revk/OpenMic/PCB/README.md

## Trademark

This is an open source project, but bear in mind you cannot sell boards bearing the Andrews & Arnold Ltd name, the A&A logo, the registered trademark AJK logo, or the GS1 allocated EANs assigned to Andrews & Arnold Ltd.

# PCBs

Audio Recorder

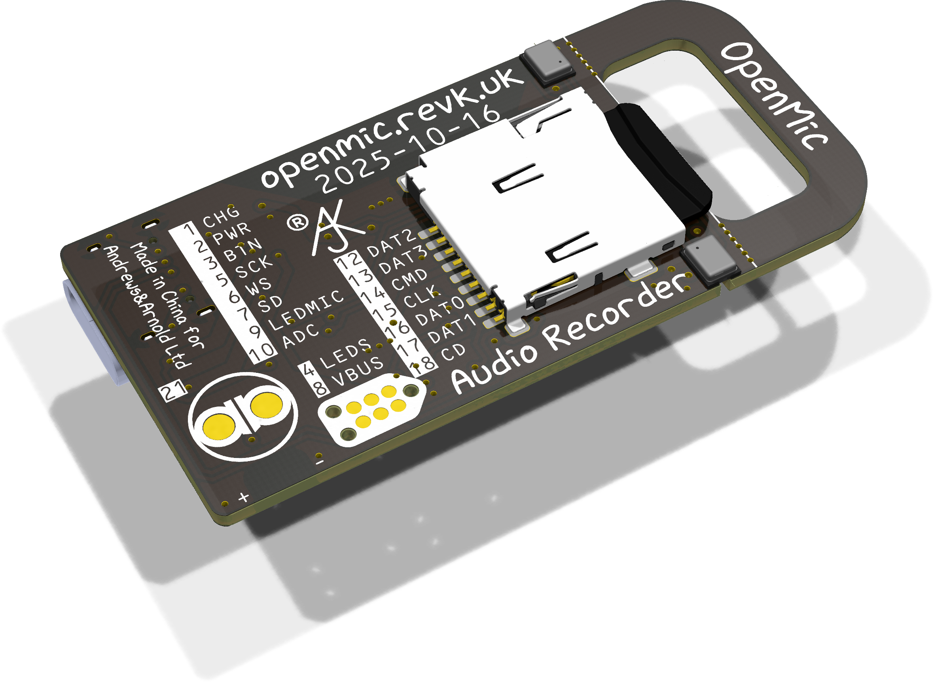
[picture p2: PCB/Recorder/Recorder-bottom.png]


Comm Badge roundel

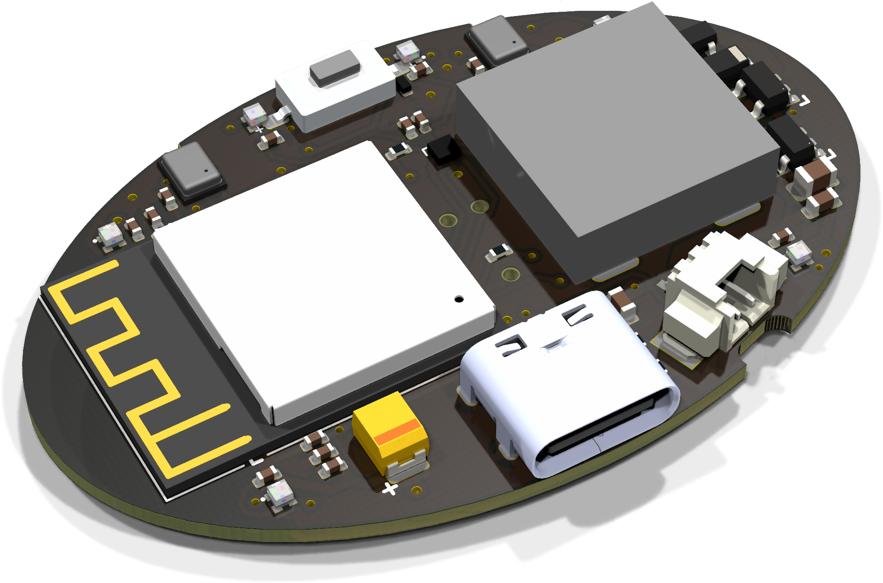
[picture p3: PCB/CommBadge/CommBadge.png]
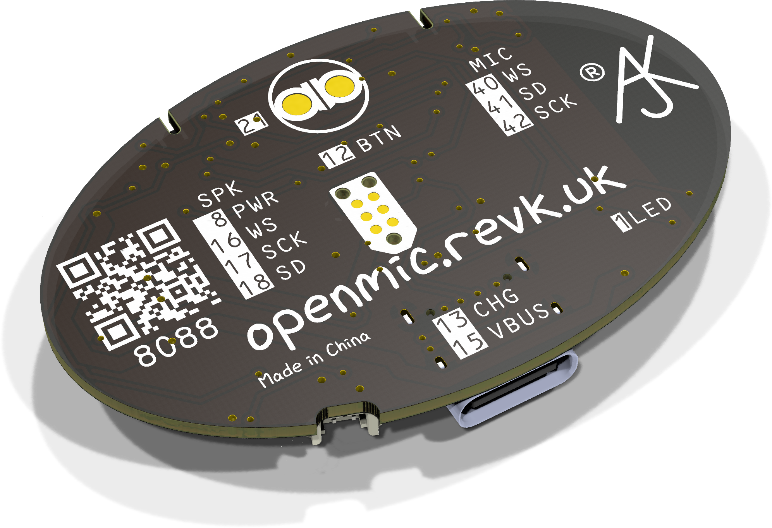
[picture p4: PCB/CommBadge/CommBadge-bottom.png]
