revk/OpenMic/PCB/Intercom/README.md

# Intercom

These files are for use in [KiCad](https://www.kicad.org).

## Trademark

This is an open source project, but bear in mind you cannot sell boards bearing the Andrews & Arnold Ltd name, the A&A logo, the registered trademark AJK logo, or the GS1 allocated EANs assigned to Andrews & Arnold Ltd.

## Images

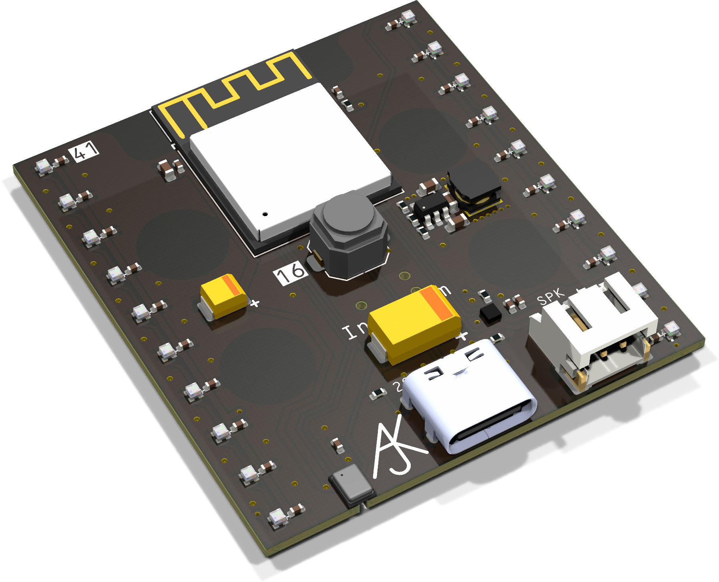
[picture p5: PCB/Intercom/Intercom.png]
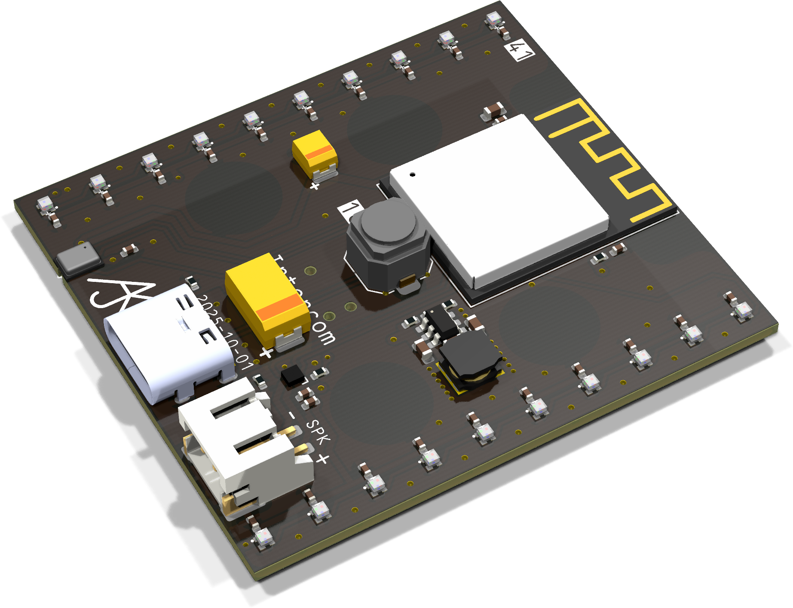
[picture p6: PCB/Intercom/Intercom-90.png]
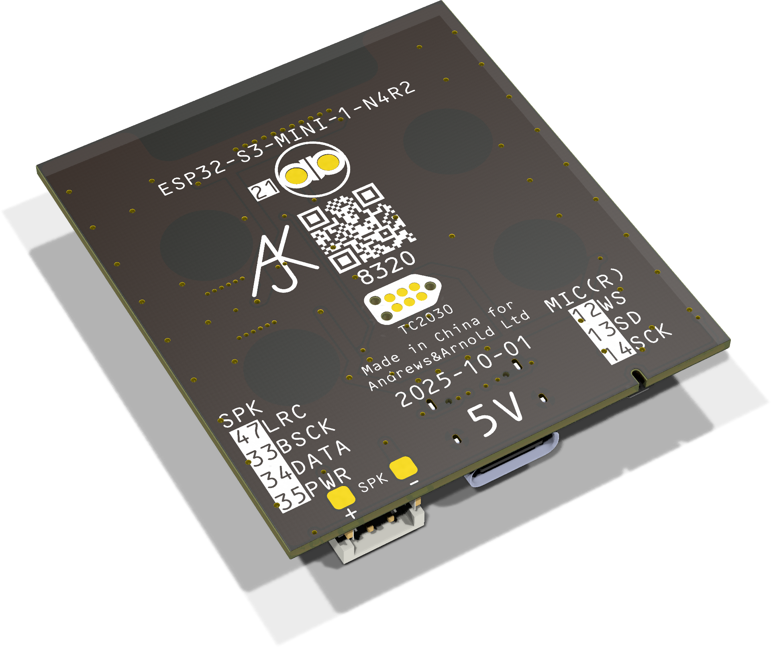
[picture p7: PCB/Intercom/Intercom-bottom.png]

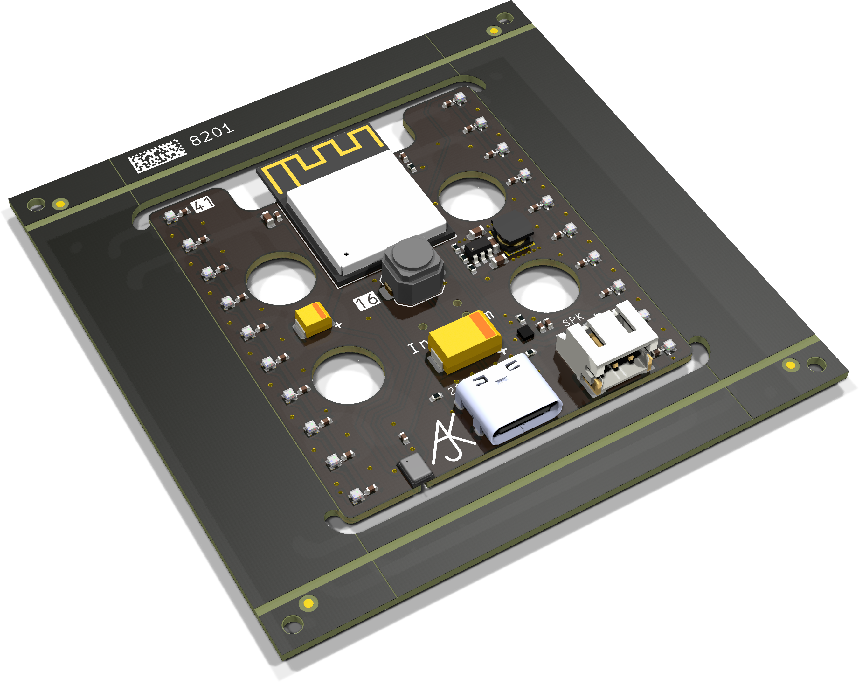
[picture p8: PCB/Intercom/Intercom-panel.png]
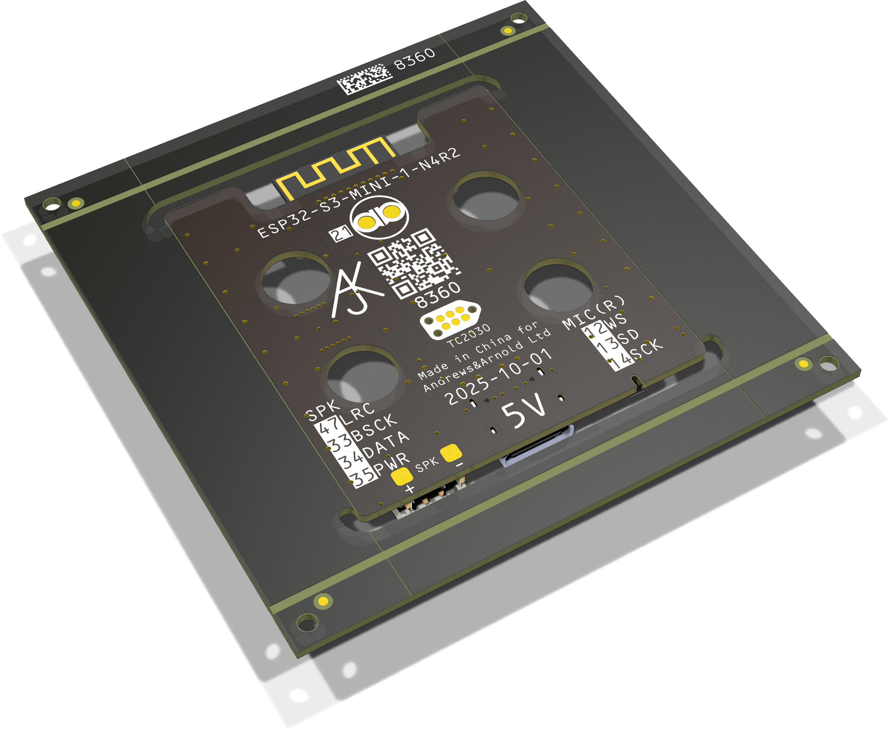
[picture p9: PCB/Intercom/Intercom-panel-bottom.png]


*Auto generated 2025-08-10T15:43:51*
