revk/OpenMic/PCB/Recorder/README.md

# Recorder

These files are for use in [KiCad](https://www.kicad.org).

## Trademark

This is an open source project, but bear in mind you cannot sell boards bearing the Andrews & Arnold Ltd name, the A&A logo, the registered trademark AJK logo, or the GS1 allocated EANs assigned to Andrews & Arnold Ltd.

## Images

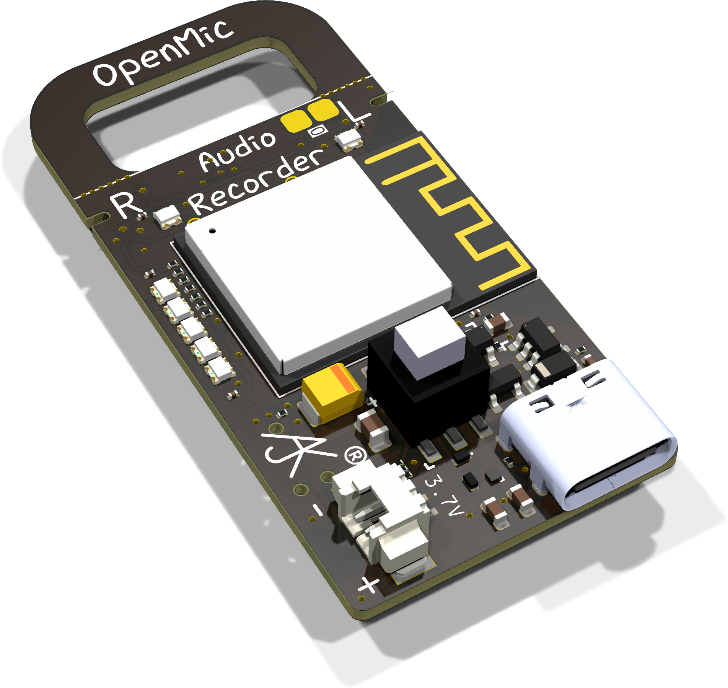
[picture p10: PCB/Recorder/Recorder-90.png]

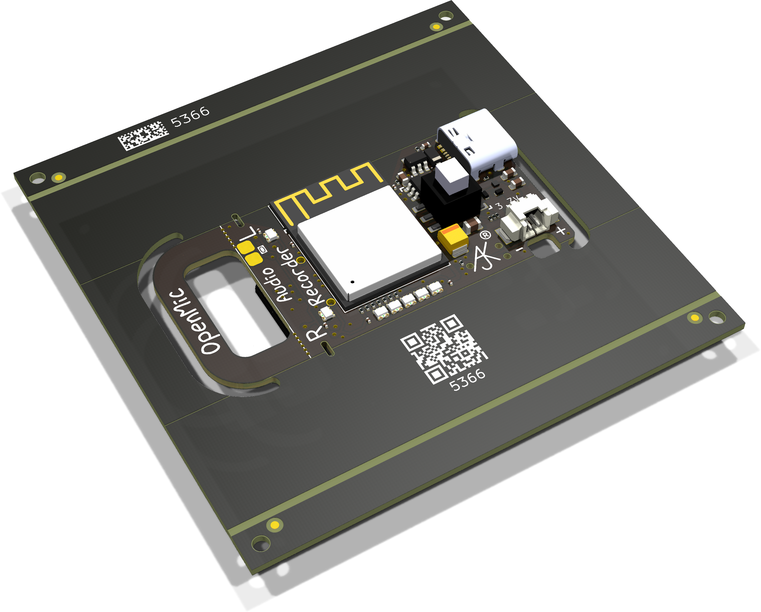
[picture p11: PCB/Recorder/Recorder-panel.png]
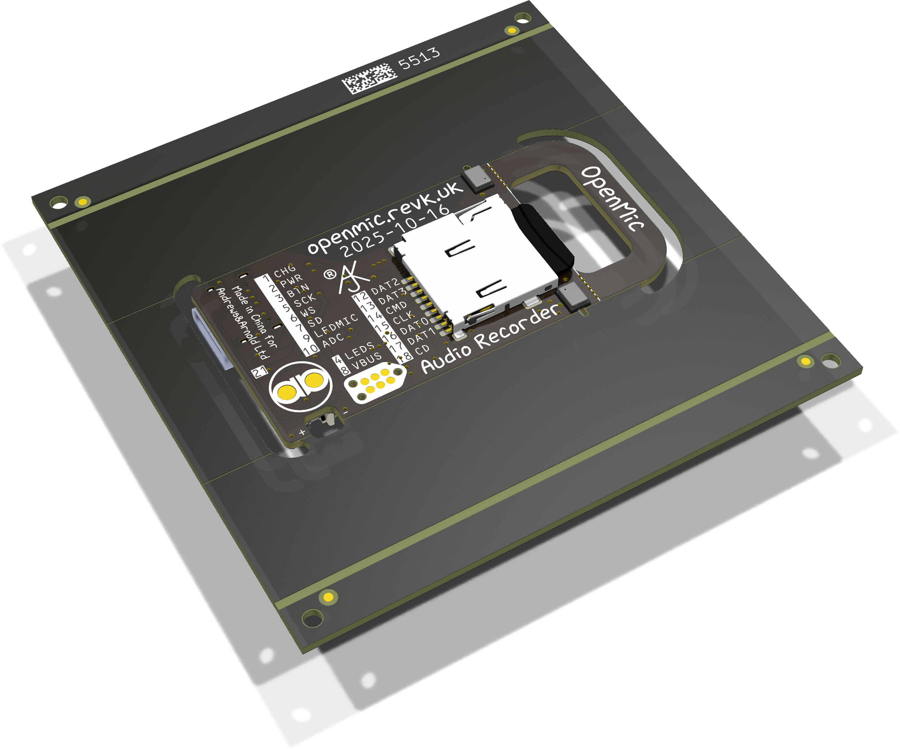
[picture p12: PCB/Recorder/Recorder-panel-bottom.png]


*Auto generated 2025-08-10T16:03:46*
