revk/OpenMic/PCB/CommBadge/README.md

# CommBadge

Top
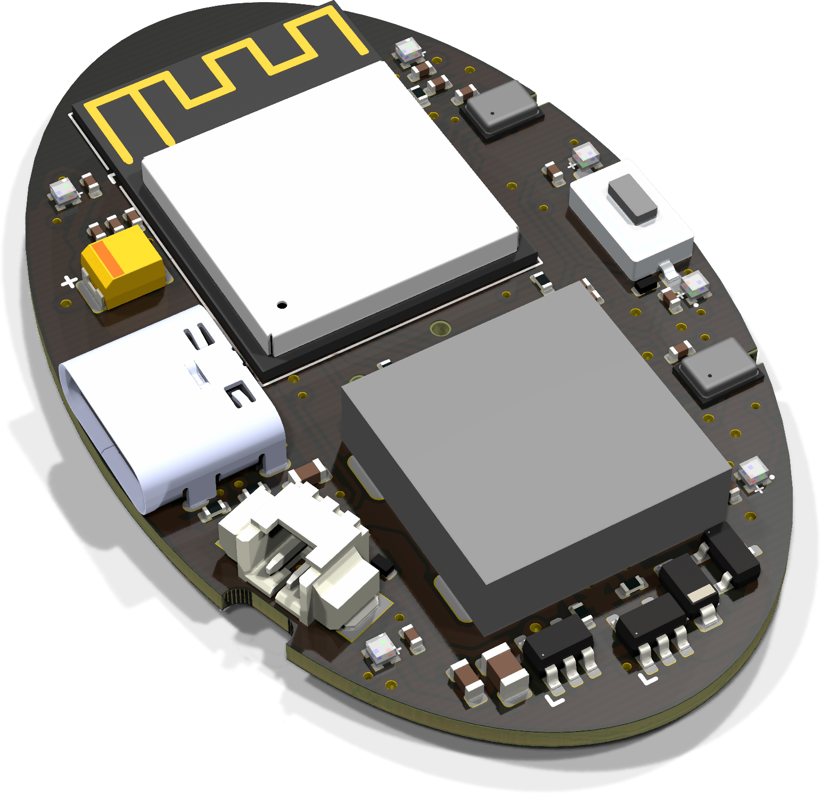
[picture p13: PCB/CommBadge/CommBadge-90.png]
Top rotated

Bottom
