revk/OpenMic/PCB/Recorder-2025-07-07-NoTag.stl

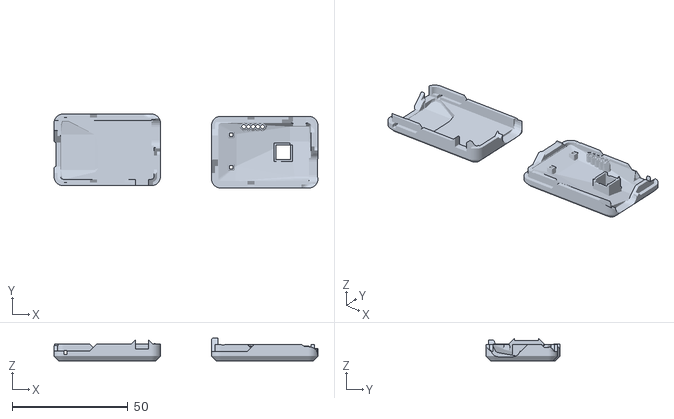
[picture p14: CAD file, 2025-08-11]
PCB/Recorder-2025-07-07-NoTag.stl
114.0 x 32.0 x 9.78
