revk/OpenMic/PCB/Recorder/RecorderB.stl

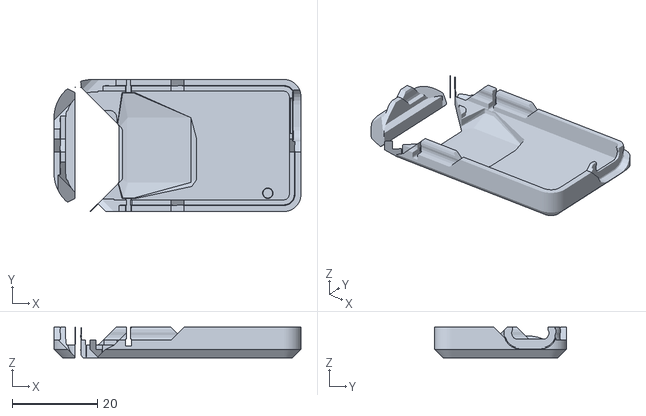
[picture p15: CAD file, 2025-10-16]
PCB/Recorder/RecorderB.stl
58.0 x 31.0 x 7.20
