revk/OpenMic/PCB/Recorder-2025-07-07.stl

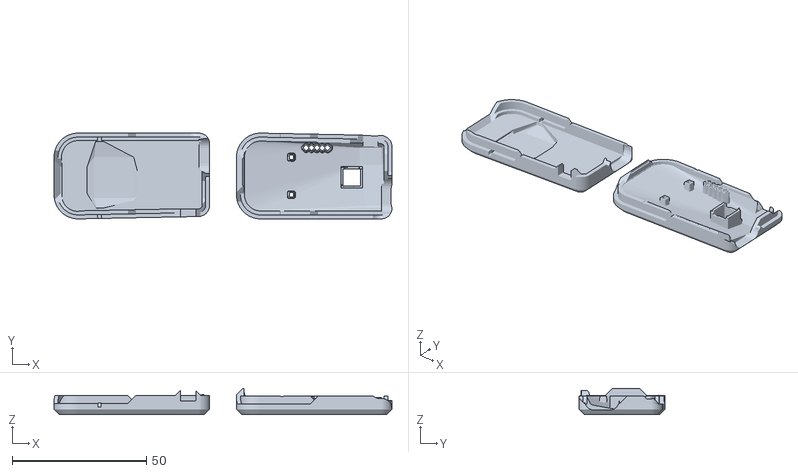
[picture p16: CAD file, 2025-08-11]
PCB/Recorder-2025-07-07.stl
126.0 x 32.0 x 9.81
