revk/OpenMic/PCB/Recorder/RecorderBatNoTagT.stl

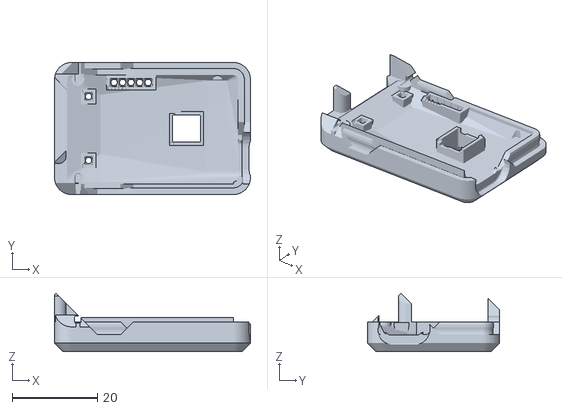
[picture p17: CAD file, 2025-10-16]
PCB/Recorder/RecorderBatNoTagT.stl
46.0 x 31.0 x 13.7
