revk/OpenMic/PCB/Recorder/RecorderT.stl

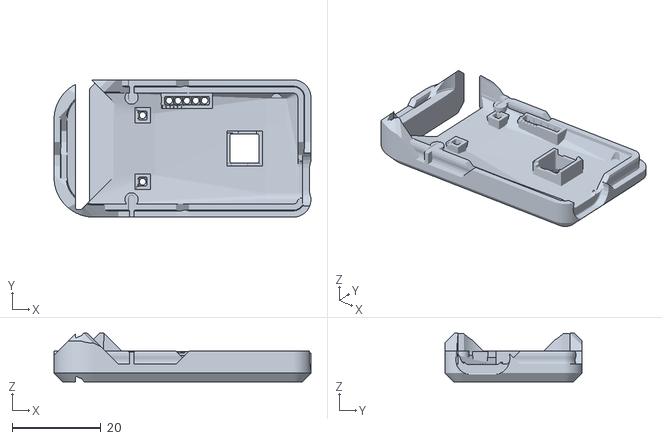
[picture p18: CAD file, 2025-10-16]
PCB/Recorder/RecorderT.stl
58.0 x 31.0 x 11.0
