revk/OpenMic/PCB/Recorder/RecorderNoTagB.stl

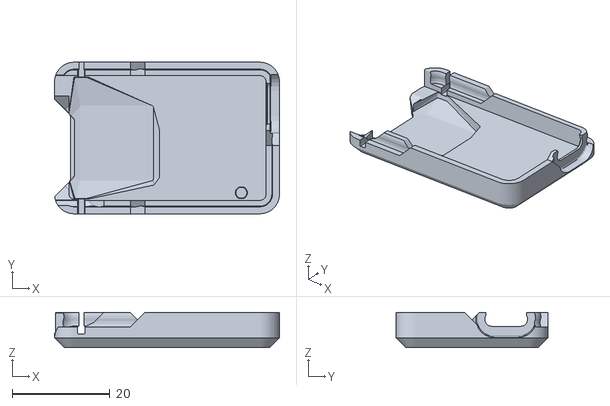
[picture p19: CAD file, 2025-10-16]
PCB/Recorder/RecorderNoTagB.stl
46.0 x 31.0 x 7.20
