revk/OpenMic/PCB/Recorder/RecorderBatB.stl

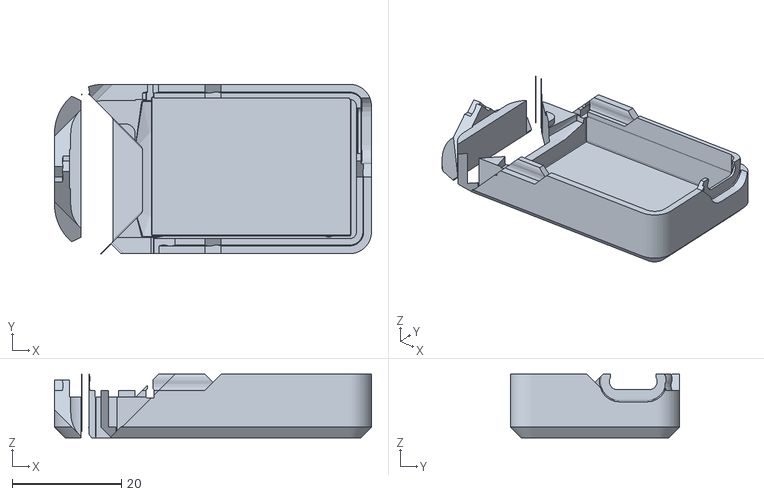
[picture p20: CAD file, 2025-10-16]
PCB/Recorder/RecorderBatB.stl
58.0 x 31.0 x 11.7
