revk/OpenMic/PCB/Recorder/RecorderBatNoTagB.stl

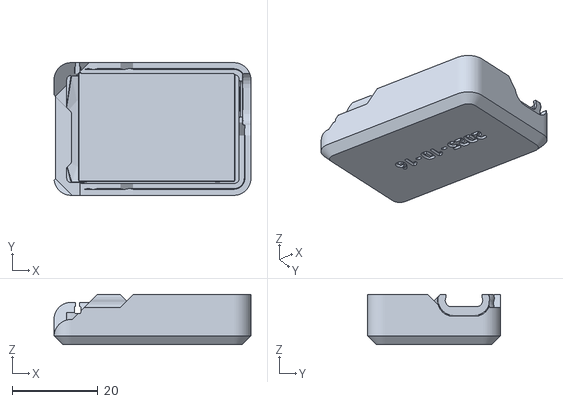
[picture p21: CAD file, 2025-10-16]
PCB/Recorder/RecorderBatNoTagB.stl
46.0 x 31.0 x 11.7
