revk/OpenMic/PCB/Recorder/RecorderBatT.stl

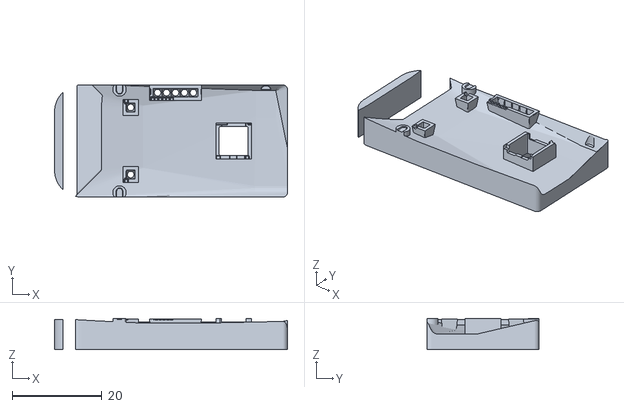
[picture p22: CAD file, 2025-10-16]
PCB/Recorder/RecorderBatT.stl
52.1 x 25.1 x 7.00
