revk/OpenMic/PCB/Recorder/RecorderNoTagT.stl

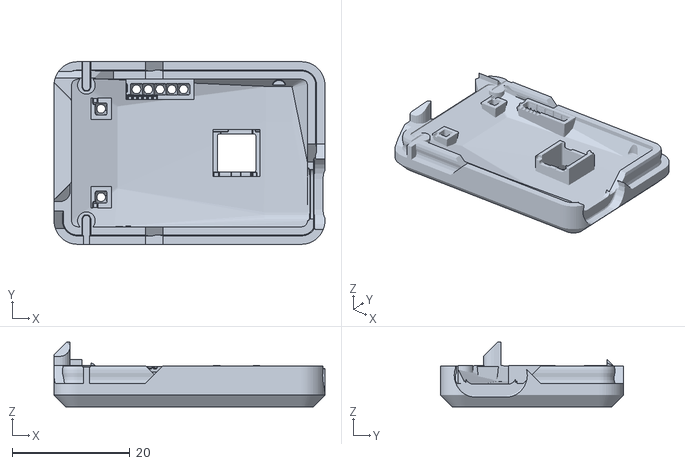
[picture p23: CAD file, 2025-10-16]
PCB/Recorder/RecorderNoTagT.stl
46.0 x 31.0 x 11.0
