revk/OpenMic/(list of files, cad)

Other CAD files:
PCB/Recorder/RecorderB.scad
PCB/Recorder/RecorderBat.scad
PCB/Recorder/RecorderBatB.scad
PCB/Recorder/RecorderBatNoTagB.scad
PCB/Recorder/RecorderBatNoTagT.scad
PCB/Recorder/RecorderBatNotTagB.scad
PCB/Recorder/RecorderBatNotTagT.scad
PCB/Recorder/RecorderBatT.scad
PCB/Recorder/RecorderNoTag.scad
PCB/Recorder/RecorderNoTagB.scad
PCB/Recorder/RecorderNoTagT.scad
PCB/Recorder/RecorderT.scad
