revk/OpenMic/(threads)

Thread 2 (2025-02-13):

Button always seems to goto sleep

sammachin, 2025-02-13:
Have got the SIP stuff mostly working on the commbadge,
The only issue I am having is the button seems to put the badge into deep sleep even with a short press, so I can't get it to answer or make a SIP call.

When I just tap the button I get the following on the serial console
E (37529) LWMQTT: Closed cleanly
E (37640) wifi_init: Wi-Fi not stop
E (37671) OpenMic: Deep sleep on button 12 high
[Disconnected]
The the device immediatly starts up again.
I'm running on USB power and have autousb set to on

revk, 2025-02-14:
What GPIO have you set.

The button is active low so needs a minus in front of the GPIO.

sammachin, 2025-02-14:
ah ok, yes that works better now, thanks.

Closed 2025-02-14.

Thread 4 (2025-07-05):

general developer docs

nickfreemandesign, 2025-07-05:
Hey there. Such a cool project and I've learned a ton from playing around with this. I picked up your recorder from your store and was able to get up and running quickly with recording to local storage. My goal has been to set up bluetooth advertising so I can connect to my phone and pass these recordings down based on particular logic (such as when mobile application requests it). Note I'm a software engineer but I've no experience in C, nor hardware including ESP32

A few things I stumbled across trying to run my own build then flash it on the device, wondering if you can guide me a bit:

- `popt` seems to be a requirement to build when running `make all`, I guess its used for your extended system config settings. I don't fully get how system pathing works to get dependencies but I have it installed using homebrew through macOS. The error is that it cant find `popt` when building
- When running `idf.py build` however I did get a build. Flashing this build however broke the device (no blinking lights and monitor seemed to indicate a loop the boot sequence was in) I assume is because that command doesnt build the submodules
- I flashed the release folder onto the device and got blinky lights again, but nothing records and the button doesnt appear responsive. Monitoring the device to figure out whats different, I don't see any meaningful logs

```
# how i flashed the release folder
esptool.py --chip esp32s3 --port /dev/cu.usbmodem101 --baud 460800 write_flash \
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
```

```
# monitor command
E (257) OpenMic: Started
E (384) RevK: Connect IoT
E (389) OpenMic: Spk init BCLK 35 DAT 36 LR 34
E (389) OpenMic: Mic mode 1
E (392) OpenMic: Spk started mode 2, 160*1*16 bits at 8000Hz
E (396) wifi_init: Wi-Fi not stop
E (398) OpenMic: Mic init CLK 44 DAT 43 WS 42
E (404) OpenMic: Mic started mode 1, 4410*1*32 bits at 44100Hz - mapped to 1*16 bits
E (514) RevK: Connect MQTT0 mqtt.iot as OpenMic:48CA43591F20
E (515) OpenMic: Mic stopped
E (2254) RevK: Connect IoT
E (5254) RevK: Connect IoT
E (8254) RevK: Connect IoT
E (11254) RevK: Connect IoT
E (12255) RevK: APSTA config mode start OpenMic-48CA43591F20
E (12266) httpd: httpd_server_init: error in listen (112)
E (14431) OpenMic: Spk stopped
E (20254) RevK: Connect IoT
E (30254) RevK: Connect IoT
E (40254) RevK: Connect IoT
E (50254) RevK: Connect IoT
```

My expectation is `bt` from the esp-idf components should be imported somewhere to confirm that bluetooth capabilities can be accessed, but also just a guess

If you don't mind giving me a nudge in the right direction, my questions are:
- What is the best way to build the source code (such that I can reproduce whats in the `release` folder) and flash to the device?
- What am I missing to get recordings working again once flashing whats in the `release` folder
- How would you best go about extending BLE advertising for file transfer

Thanks for the inspiration here. Really cool project

nickfreemandesign, 2025-07-05:
thank you for the reply. super interesting

>Yes, my code and tools expects popt.

when you build for your release, what is the filepath for your `popt`? id like to replicate on my end to ensure the binary is there

>Bluetooth mic is a nightmare

agreed. i intent to store to local file system as you have, then on long button press, send files to phone one by one

when i flashed the `release` folder, i got lights blinking but was not able to record anymore. do you know of any other steps i may need to take, or what i may have missed to flash the `release` folder onto the device?

revk, 2025-07-06:
It is standard on linux, on Mac I think it is home-brew. `apt install libpopt-dev`

I do file transfer over WiFi already on power off, post to a URL, does that help?

I would carefully check GPIOs that are set. The release should have the defaults, maybe fully erase flash first. See bottom of https://github.com/revk/ESP32-RevK for more details on flashing.

nickfreemandesign, 2025-07-18:
One more clue I have because I bought 2 recorders, is the working one that I never flashed onto, shows the SD card mounting

```
E (403) RevK: Connect IoT
E (409) OpenMic: Mic mode 1
E (413) wifi_init: Wi-Fi not stop
E (415) OpenMic: Mic init CLK 5 DAT 7 WS 6
E (416) OpenMic: Mic started mode 1, 4410*2*32 bits at 44100Hz - mapped to 2*16 bits
E (527) RevK: Connect MQTT0 mqtt.iot as OpenMic:48CA43591F48
E (528) OpenMic: Mic stopped
E (1456) OpenMic: SD Card mounted
E (2300) RevK: Connect IoT
E (5300) RevK: Connect IoT
E (8300) RevK: Connect IoT
E (9842) OpenMic: Mic mode 3
E (9847) wifi_init: Wi-Fi not stop
E (9849) OpenMic: Mic init CLK 5 DAT 7 WS 6
E (9850) OpenMic: Mic started mode 3, 4410*2*32 bits at 44100Hz - mapped to 2*16 bits
E (9862) OpenMic: Recording opened /sd/0012-.WAV sync 10584000 max 635040000
E (17058) RevK: Connect MQTT0 mqtt.iot as OpenMic:48CA43591F48
E (17060) OpenMic: Mic stopped
E (17067) OpenMic: Recording closed /sd/0012-.WAV at 1252440
E (17070) OpenMic: SD access 4bit: 1252440 bytes 410ms (3049kB/sec) /sd/0012-.WAV
E (17300) RevK: Connect IoT
E (20300) RevK: Connect IoT
E (23300) RevK: Connect IoT
E (26300) RevK: Connect IoT
E (28912) wifi_init: Wi-Fi not stop
E (28914) OpenMic: Deep sleep on button 1 low
```

nickfreemandesign, 2025-07-21:
All GPIO settings are the same. I can send over a cross reference of both if thats helpful. My expectation is I can just flash this release folder and the settings would reset with the flashing. My goal is to develop on top of OpenMic, but currently flashing the Release folder doesn't have the expected outcome

nickfreemandesign, 2025-07-21:
gotcha. would you be open to collaborating on this a bit further? my email is my github handle at gmail

Closed 2025-07-21.
