revk/OpenMic/PCB/Recorder/Recorder.kicad_pcb

## KiCad design PCB/Recorder/Recorder.kicad_pcb (2025-10-16)

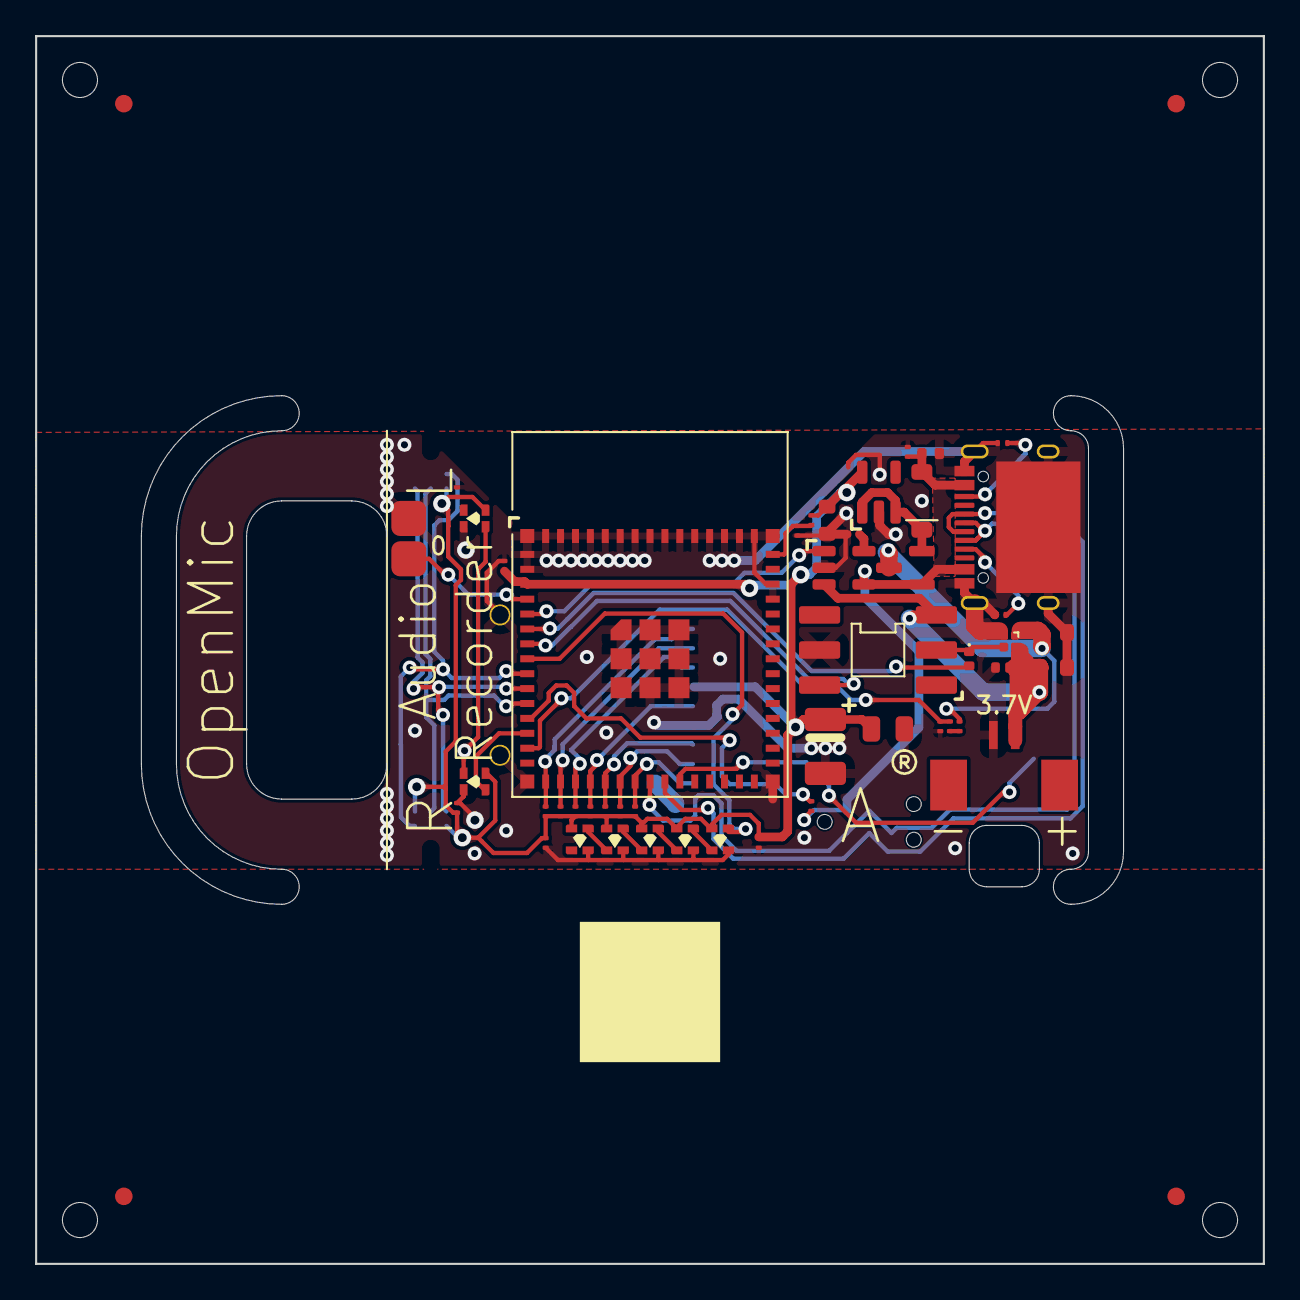
[picture p24: board Recorder.kicad_pcb from above]

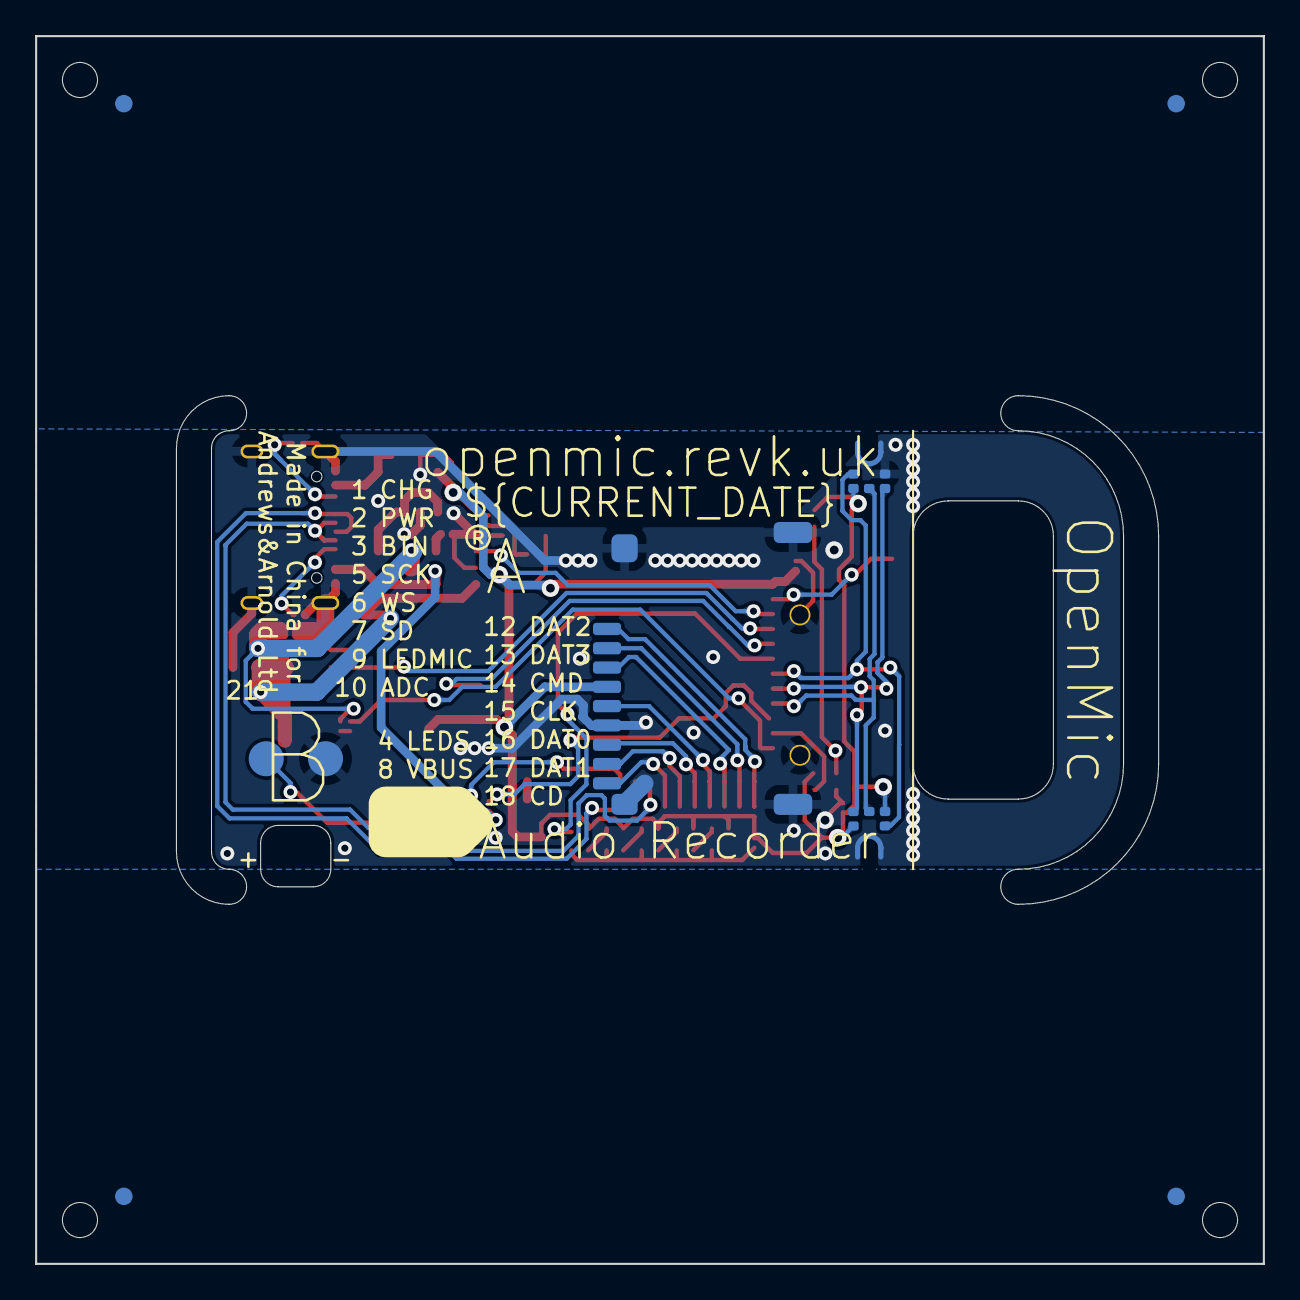
[picture p25: board Recorder.kicad_pcb from below]

Board: 2 copper layers, 70.0 x 70.0 mm, 57 parts (7 on the bottom side), 38 nets.

Parts:
BT1: Battery; LiPo1
C1, C3, C5: 22uF; C_0603
C2: 1uF; C_0201
C4, C10, C11, C12, C14: 100nF; C_0201
C6: 220uF Tant; CP_EIA-3528-21_Kemet-B
C7: 10uF 6.3V; C_0402
C9: 100uF; C_0805
D1: D; D_0402
D2: DFN1006-2L
D3: MBR0530; D_SOD-123
D4, D5, D6, D7, D8, D9, D10: XL-1010RGBC-WS2812B; SMD1615
J1: Reset; AA-Pad
J3: TC2030-USB-NL-DS; Tag-Connect_TC2030-IDC-NL_2x03_P1.27mm_Vertical
J4: TF_PUSH
J5: USB-C-Socket-H
J6: Battery; 1.25T-2PWT (Molex 532610271)
PCB1: 70x70; PCB7070
Q1: CJ2301; SOT-23
R1, R2, R3, R4, R5, R6, R7, R9, R10, R11: 10K; R_0201
R8, R12, R13: 5K1; R_0201
R14, R15, R16: 100K 1%; R_0201
SW1: SW_Push_DPDT
TP1, TP2: TestPoint; PAD-2mm
U1: ESP32-S3-MINI-1-N4R2; ESP32-S3-MINI-1
U2: TPS22916CNYFPR; WCSP-4-0.78x0.78
U3: TP4054; SOT-23-5
U4: ME6211C33M5G-N; SOT-23-5-90
U5, U6: ICS-43434; ICS43434_MEMS_Mic_Open
V1, V2: VCUT70N

Connections:
+3V3: C4.1, C5.1, C6.1, C9.1, C10.2, C11.2, C12.1, C14.1, D4.3 (+), D5.3 (+), D6.3 (+), D7.3 (+), D8.3 (+), D9.3 (+), D10.3 (+), J4.4 (VDD), R2.1, R3.1, R4.1, R5.1, R6.1, R7.1, R9.1, R10.1, U1.3 (3V3), U4.5 (OUT), U5.5 (VDD), U6.2 (LR), U6.5 (VDD)
ADC: R15.2, R16.1, U1.14 (GPIO10)
BLINK: D4.2 (I), U1.8 (GPIO4)
BTN: SW1.4 (C), U1.7 (GPIO3)
CHARGING: U1.5 (GPIO1), U3.1 (STAT)
D+: J3.4 (D+), J5.A6 (D+), J5.B6 (D+), U1.24 (GPIO20)
D-: J3.2 (NC), J3.3 (D-), J3.6 (NC), J5.A7 (D-), J5.B7 (D-), U1.23 (GPIO19)
GND: C1.2, C2.2, C3.2, C4.2, C5.2, C6.2, C7.2, C9.2, C10.1, C11.1, C12.2, C14.2, D2.1, D4.1 (-), D5.1 (-), D6.1 (-), D7.1 (-), D8.1 (-), D9.1 (-), D10.1 (-), J1.1, J3.5 (GND), J4.6 (VSS), J4.S (SHIELD), J5.A1 (GND), J5.A12 (GND), J5.B1 (GND), J5.B12 (GND), J5.S1 (SHIELD), J6.2, R8.1, R11.2, R12.2, R13.1, R16.2, SW1.5 (B), TP2.1, U1.1 (GND), U1.2 (GND), U1.42 (GND), U1.43 (GND), U1.46 (GND), U1.47 (GND), U1.48 (GND), U1.49 (GND), U1.50 (GND), U1.51 (GND), U1.52 (GND), U1.53 (GND), U1.54 (GND), U1.55 (GND), U1.56 (GND), U1.57 (GND), U1.58 (GND), U1.59 (GND), U1.60 (GND), U1.61 (GND), U1.62 (GND), U1.63 (GND), U1.64 (GND), U1.65 (GND), U2.B1 (GND), U3.2 (VSS), U4.2 (GND), U5.2 (LR), U5.3 (GND), U6.3 (GND)
LEDMIC: D7.2 (I), U1.13 (GPIO9)
unnamed: D1.1 (K), SW1.2 (B), U2.B2 (ON)
unnamed: D3.1 (K), Q1.2 (S), U4.1 (IN), U4.3 (EN)
unnamed: D4.4 (O), D5.2 (I)
unnamed: D5.4 (O), D6.2 (I)
unnamed: D6.4 (O), D8.2 (I)
unnamed: D7.4 (O), D9.2 (I)
unnamed: D8.4 (O), D10.2 (I)
unnamed: J1.2, U1.25 (GPIO21)
unnamed: J5.A5 (CC1), R12.1
unnamed: J5.B5 (CC2), R13.2
unnamed: R14.2, R15.1
unnamed: C2.1, R2.2, U1.45 (EN)
unnamed: TP1.1, U1.4 (GPIO0)
unnamed: R1.1, U1.12 (GPIO8)
unnamed: R8.2, U3.5 (PROG)
PWR: D1.2 (A), U1.6 (GPIO2)
SCK: U1.9 (GPIO5), U5.4 (SCK), U6.4 (SCK)
SD: U1.11 (GPIO7), U5.6 (SD), U6.6 (SD)
SDCD: J4.9 (CD), R3.2, U1.22 (GPIO18)
SDCLK: J4.5 (CLK), R6.2, U1.19 (GPIO15)
SDCMD: J4.3 (CMD), R7.2, U1.18 (GPIO14)
SDDAT0: J4.7 (DAT0), R5.2, U1.20 (GPIO16)
SDDAT1: J4.8 (DAT1), R4.2, U1.21 (GPIO17)
SDDAT2: J4.1 (DAT2), R10.2, U1.16 (GPIO12)
SDDAT3: J4.2 (DAT3/CD), R9.2, U1.17 (GPIO13)
VBATCHG: C1.1, D2.2, J6.1, SW1.3 (C), U2.A2 (VIN), U3.3 (VBAT)
VBUS: C7.1, D3.2 (A), J3.1 (VBUS), J5.A4 (VBUS), J5.A9 (VBUS), J5.B4 (VBUS), J5.B9 (VBUS), Q1.1 (G), R1.2, R11.1, U3.4 (VDD)
VSWITCHED: C3.1, Q1.3 (D), R14.1, U2.A1 (VOUT)
WS: U1.10 (GPIO6), U5.1 (WS), U6.1 (WS)
