revk/OpenMic/PCB/Intercom/Intercom.kicad_pcb

## KiCad design PCB/Intercom/Intercom.kicad_pcb (2025-04-02)

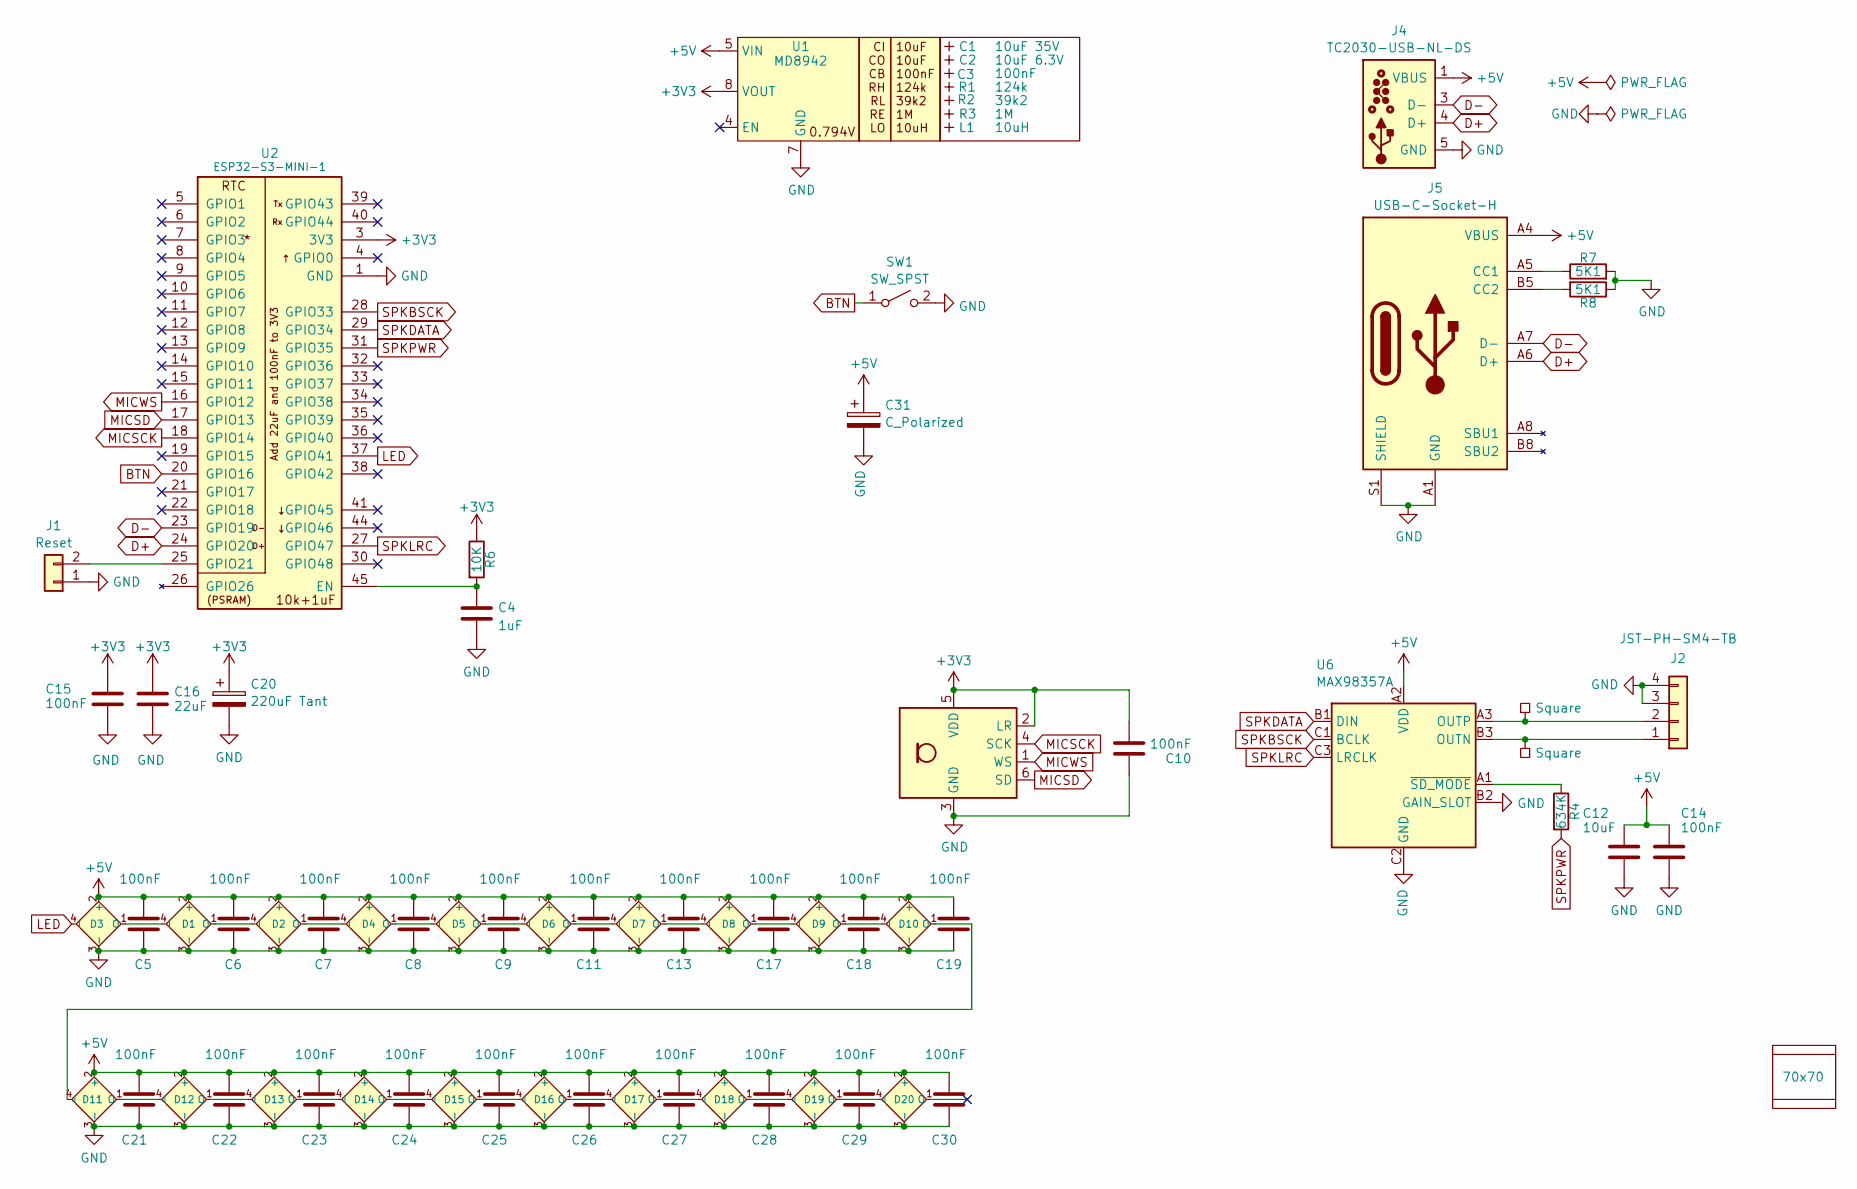
[picture p26: schematic Intercom.kicad_sch]

Parts:
C1: 10uF 35V; C_0603_; MPN C194427
C2: 10uF 6.3V; C_0603_; MPN C1691
C3: 100nF; C_0603_
C4: 1uF; C_0402
C5, C6, C7, C8, C9, C10, C11, C13, C14, C15, C17, C18, C19, C21, C22, C23, C24, C25, C26, C27, C28, C29, C30: 100nF; C_0402
C12: 10uF; C_0402; MPN C15525
C16: 22uF; C_0603
C20: 220uF Tant; CP_EIA-3528-21_Kemet-B; MPN C122649
C31: C_Polarized; CP_EIA-7343-31_Kemet-D; MPN C106188
D1, D2, D3, D4, D5, D6, D7, D8, D9, D10, D11, D12, D13, D14, D15, D16, D17, D18, D19, D20: XL-1010RGBC-WS2812B; SMD1010; MPN C5349953
J1: Reset; AA-Pad
J2: JST-PH-SM4-TB; JST_PH_S2B-PH-SM4-TB_1x02-1MP_P2.00mm_Horizontal; MPN C295747
J4: TC2030-USB-NL-DS; Tag-Connect_TC2030-IDC-NL_2x03_P1.27mm_Vertical
J5: USB-C-Socket-H; MPN C709357
L1: 10uH; L_4x4_
P1, P2: Square; PAD-2mm
PCB1: 70x70; PCB7070
R1: 124k; R_0402_
R2: 39k2; R_0402_
R3: 1M; R_0402_
R4: 634K; R_0402
R6: 10K; R_0402
R7, R8: 5K1; R_0402
SW1: SW_SPST; SW_Push_1TS009xxxx-xxxx-xxxx_6x6x5mm; MPN C390925
U1: MD8942; SOT-23-6-MD8942; MPN C2684786
U2: ESP32-S3-MINI-1; MPN C3013941
U4: ICS43434; ICS43434_MEMS_Mic_Open; MPN C5656610
U6: MAX98357A; WLP-1.437mmx1.347mm-0.21mm-ball; MPN C2682619
V2, V3: VCUT70N

Connections:
+3V3: C10.2, C15.1, C16.1, C20.1, R6.1, U1.8 (VOUT), U2.3 (3V3), U4.2 (LR), U4.5 (VDD)
+5V: C5.2, C6.2, C7.2, C8.2, C9.2, C11.2, C12.1, C13.2, C14.1, C17.2, C18.2, C19.2, C21.2, C22.2, C23.2, C24.2, C25.2, C26.2, C27.2, C28.2, C29.2, C30.2, C31.1, D1.2 (+), D2.2 (+), D3.2 (+), D4.2 (+), D5.2 (+), D6.2 (+), D7.2 (+), D8.2 (+), D9.2 (+), D10.2 (+), D11.2 (+), D12.2 (+), D13.2 (+), D14.2 (+), D15.2 (+), D16.2 (+), D17.2 (+), D18.2 (+), D19.2 (+), D20.2 (+), J4.1 (VBUS), J5.A4 (VBUS), J5.A9 (VBUS), J5.B4 (VBUS), J5.B9 (VBUS), U1.5 (VIN), U6.A2 (VDD)
BTN: SW1.1 (A), U2.20 (GPIO16)
D+: J4.4 (D+), J5.A6 (D+), J5.B6 (D+), U2.24 (GPIO20)
D-: J4.2 (NC), J4.3 (D-), J4.6 (NC), J5.A7 (D-), J5.B7 (D-), U2.23 (GPIO19)
GND: C4.2, C5.1, C6.1, C7.1, C8.1, C9.1, C10.1, C11.1, C12.2, C13.1, C14.2, C15.2, C16.2, C17.1, C18.1, C19.1, C20.2, C21.1, C22.1, C23.1, C24.1, C25.1, C26.1, C27.1, C28.1, C29.1, C30.1, C31.2, D1.3 (-), D2.3 (-), D3.3 (-), D4.3 (-), D5.3 (-), D6.3 (-), D7.3 (-), D8.3 (-), D9.3 (-), D10.3 (-), D11.3 (-), D12.3 (-), D13.3 (-), D14.3 (-), D15.3 (-), D16.3 (-), D17.3 (-), D18.3 (-), D19.3 (-), D20.3 (-), J1.1, J2.3, J2.4, J4.5 (GND), J5.A1 (GND), J5.A12 (GND), J5.B1 (GND), J5.B12 (GND), J5.S1 (SHIELD), R7.2, R8.1, SW1.2 (B), U1.2 (GND), U1.7 (GND), U2.1 (GND), U2.2 (GND), U2.42 (GND), U2.43 (GND), U2.46 (GND), U2.47 (GND), U2.48 (GND), U2.49 (GND), U2.50 (GND), U2.51 (GND), U2.52 (GND), U2.53 (GND), U2.54 (GND), U2.55 (GND), U2.56 (GND), U2.57 (GND), U2.58 (GND), U2.59 (GND), U2.60 (GND), U2.61 (GND), U2.62 (GND), U2.63 (GND), U2.64 (GND), U2.65 (GND), U4.3 (GND), U6.B2 (GAIN_SLOT), U6.C2 (GND)
LED: D3.4 (I), U2.37 (GPIO41)
MICSCK: U2.18 (GPIO14), U4.4 (SCK)
MICSD: U2.17 (GPIO13), U4.6 (SD)
MICWS: U2.16 (GPIO12), U4.1 (WS)
unnamed: D1.4 (I), D3.1 (O)
unnamed: D1.1 (O), D2.4 (I)
unnamed: D2.1 (O), D4.4 (I)
unnamed: D4.1 (O), D5.4 (I)
unnamed: D5.1 (O), D6.4 (I)
unnamed: D6.1 (O), D7.4 (I)
unnamed: D7.1 (O), D8.4 (I)
unnamed: D8.1 (O), D9.4 (I)
unnamed: D9.1 (O), D10.4 (I)
unnamed: D10.1 (O), D11.4 (I)
unnamed: D11.1 (O), D12.4 (I)
unnamed: D12.1 (O), D13.4 (I)
unnamed: D13.1 (O), D14.4 (I)
unnamed: D14.1 (O), D15.4 (I)
unnamed: D15.1 (O), D16.4 (I)
unnamed: D16.1 (O), D17.4 (I)
unnamed: D17.1 (O), D18.4 (I)
unnamed: D18.1 (O), D19.4 (I)
unnamed: D19.1 (O), D20.4 (I)
unnamed: J1.2, U2.25 (GPIO21)
unnamed: J2.1, P2.1, U6.B3 (OUTN)
unnamed: J2.2, P1.1, U6.A3 (OUTP)
unnamed: J5.A5 (CC1), R7.1
unnamed: J5.B5 (CC2), R8.2
unnamed: C4.1, R6.2, U2.45 (EN)
unnamed: R4.1, U6.A1 (~SD_MODE)
SPKBSCK: U2.28 (GPIO33), U6.C1 (BCLK)
SPKDATA: U2.29 (GPIO34), U6.B1 (DIN)
SPKLRC: U2.27 (GPIO47), U6.C3 (LRCLK)
SPKPWR: R4.2, U2.31 (GPIO35)

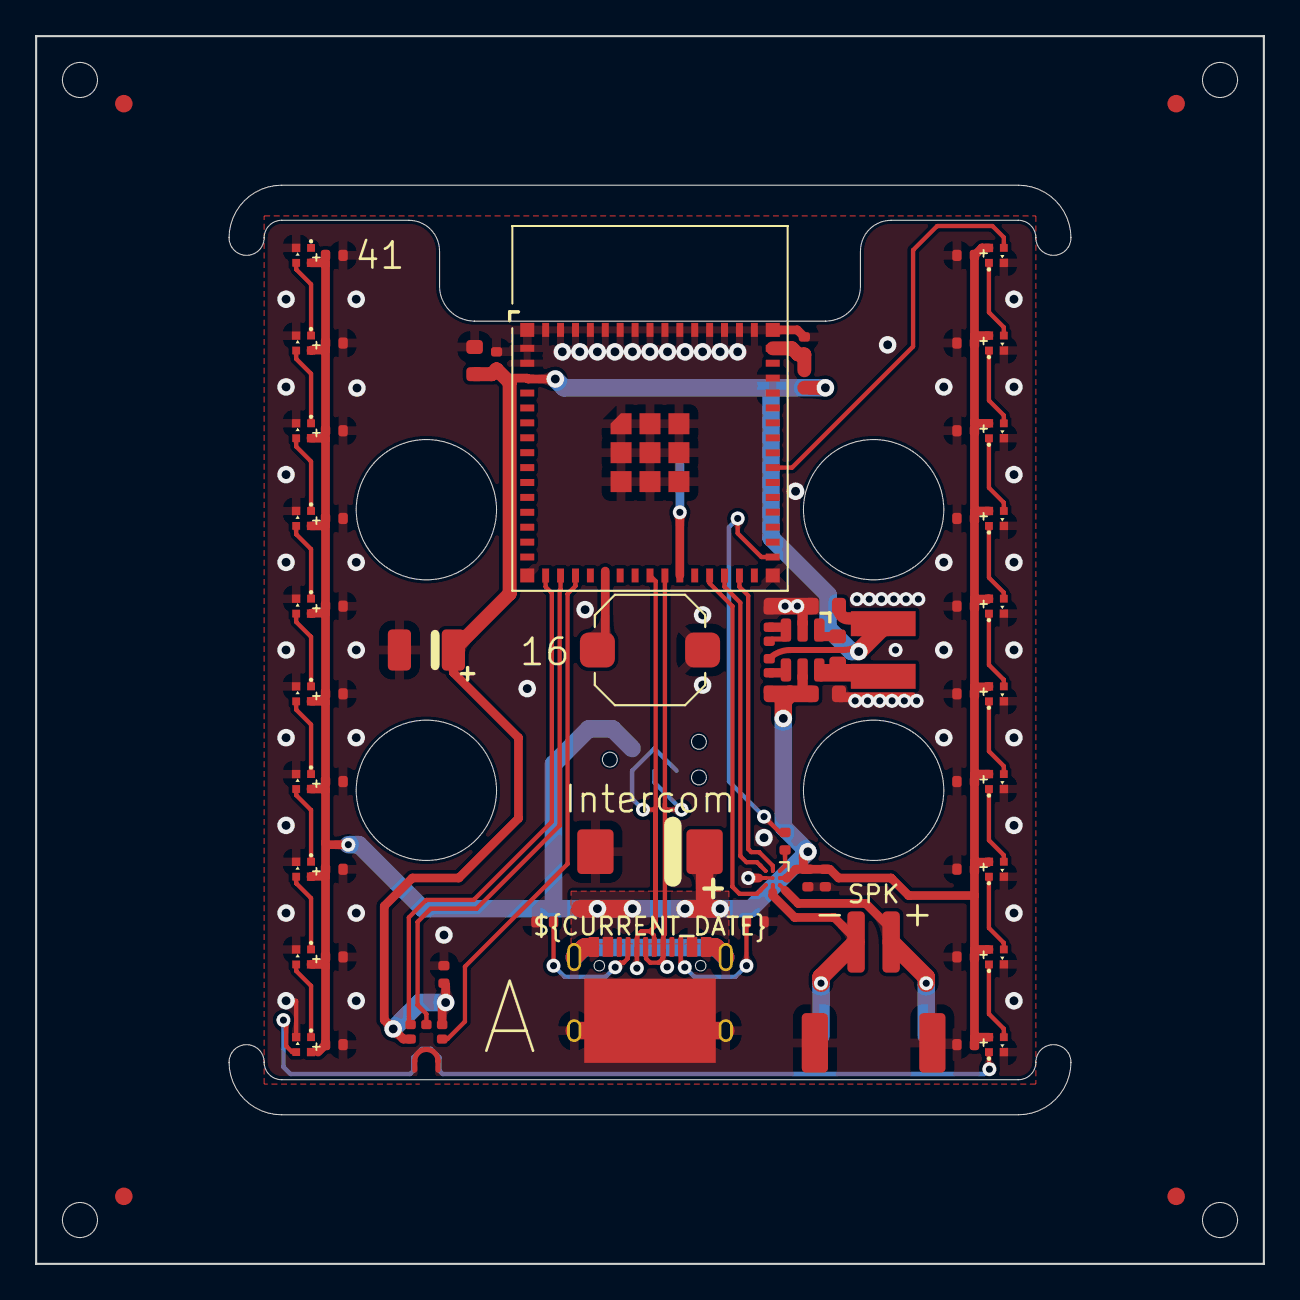
[picture p27: board Intercom.kicad_pcb from above]

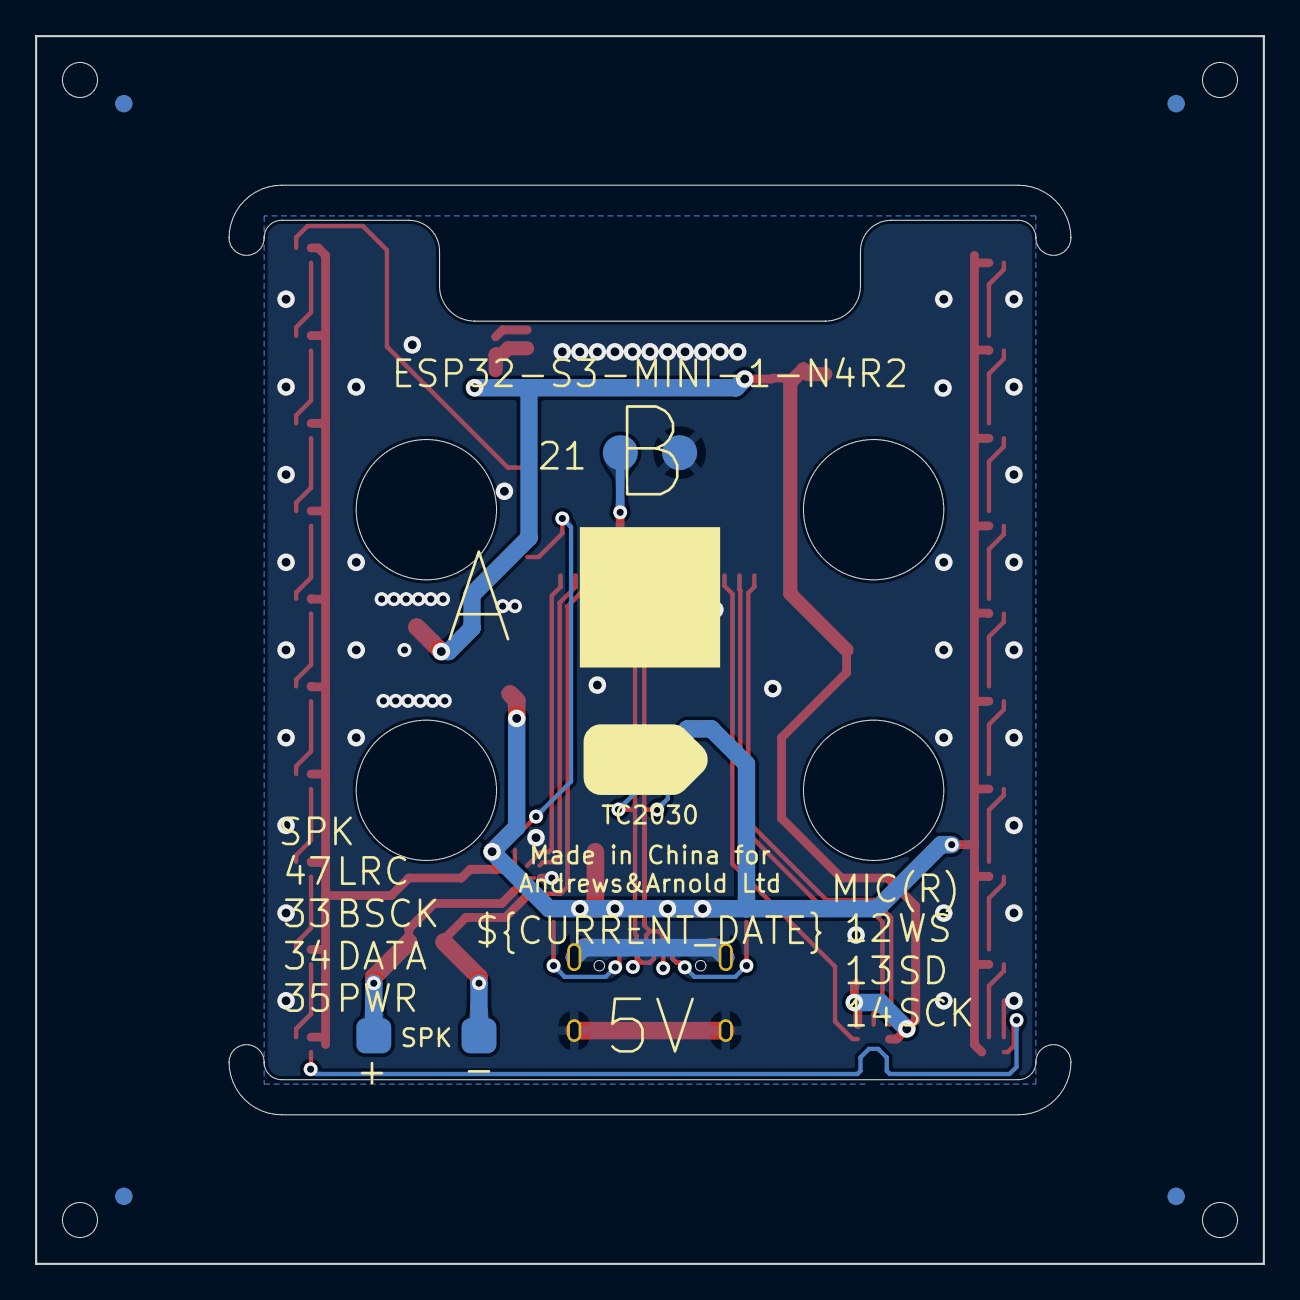
[picture p28: board Intercom.kicad_pcb from below]

Board: 2 copper layers, 70.0 x 70.0 mm, 73 parts (4 on the bottom side), 40 nets.
