revk/OpenMic/PCB/CommBadge/CommBadge.kicad_pcb

## KiCad design PCB/CommBadge/CommBadge.kicad_pcb (2025-01-23)

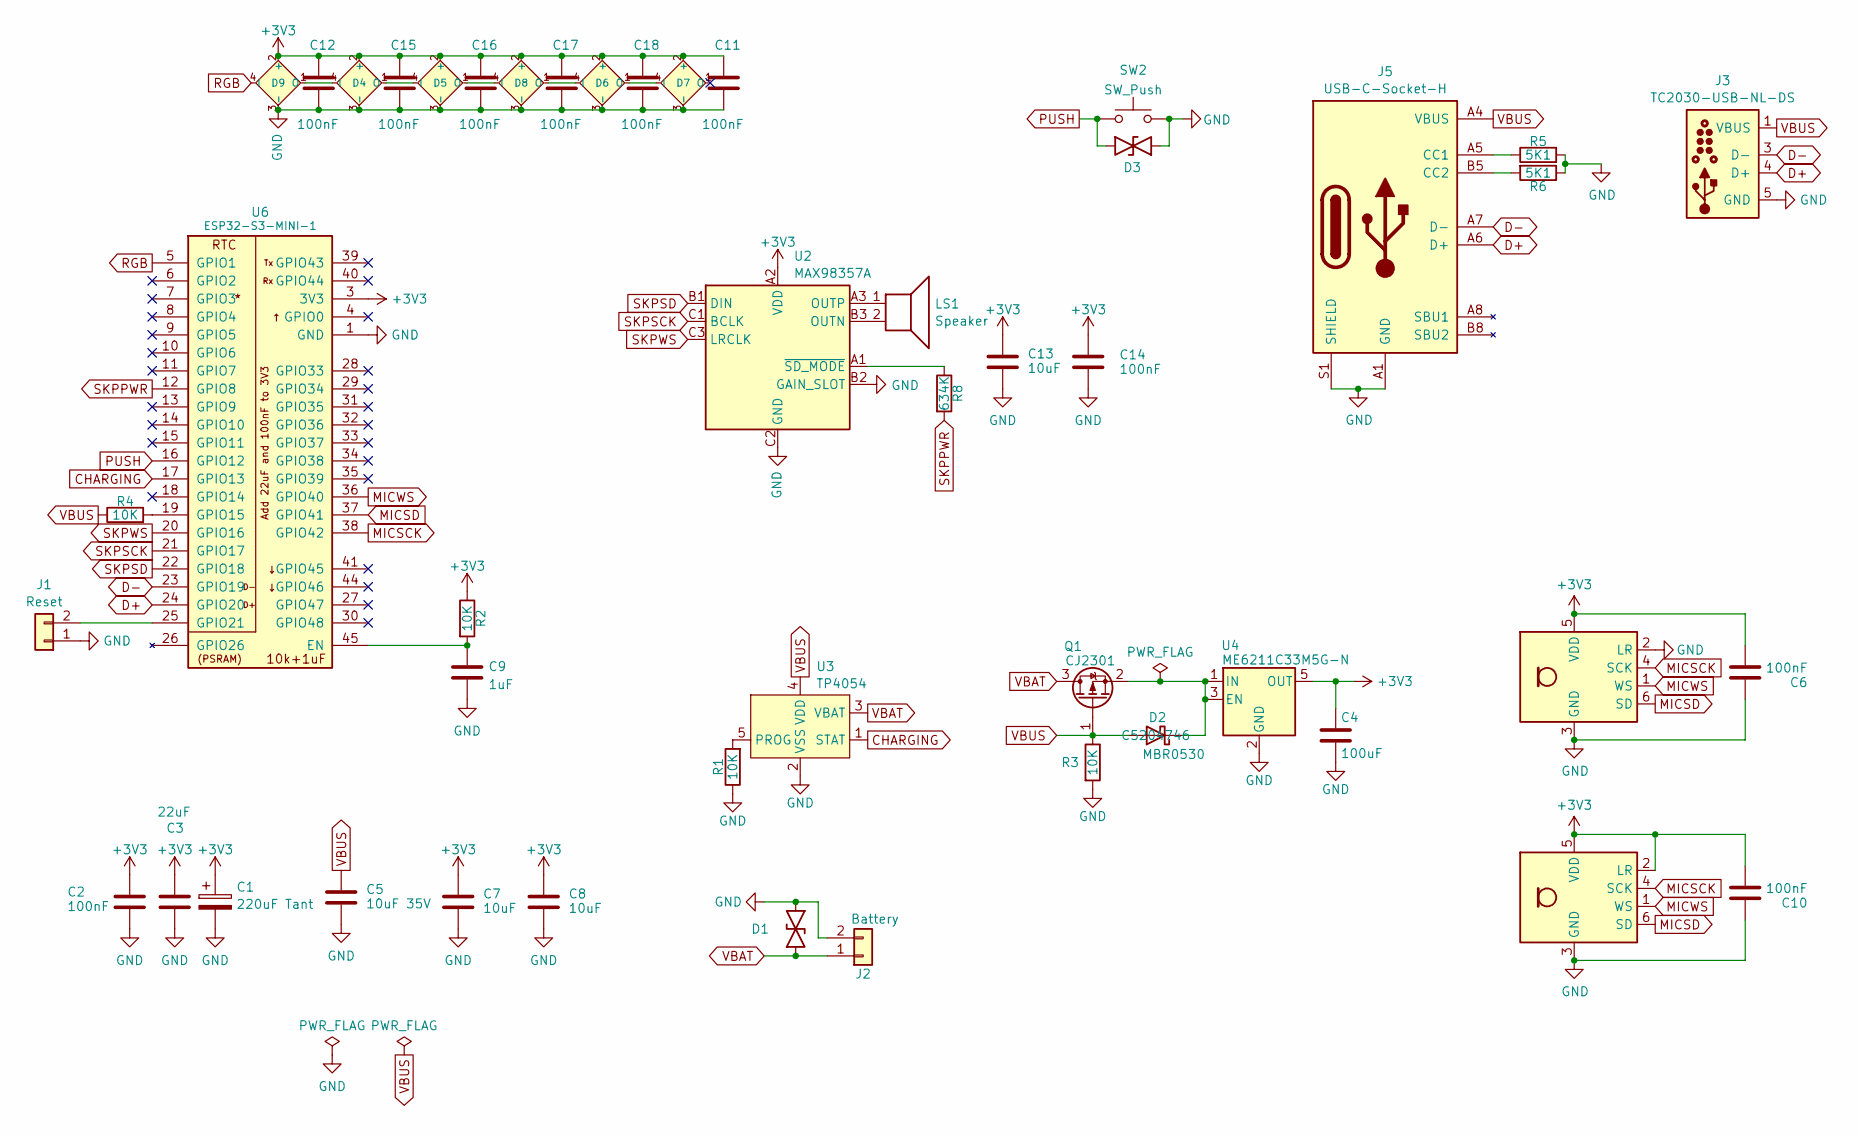
[picture p29: schematic CommBadge.kicad_sch, LED driver]

Parts:
C1: 220uF Tant
C2, C6, C10, C11, C12, C14, C15, C16, C17, C18: 100nF
C3: 22uF
C4: 100uF
C5: 10uF 35V
C7, C8, C13: 10uF
C9: 1uF
D1, D3: DFN1006-2L; MPN C5137770
D2: MBR0530; MPN C5204746
D4, D5, D6, D7, D8, D9: XL-1010RGBC-WS2812B; MPN C5349953
J1: Reset
J2: Battery
J3: TC2030-USB-NL-DS; Tag-Connect_TC2030-IDC-NL_2x03_P1.27mm_Vertical
J5: USB-C-Socket-H; MPN C709357
LS1: Speaker
Q1: CJ2301; SOT-23
R1, R2, R3, R4: 10K
R5, R6: 5K1
R8: 634K
SW2: SW_Push
U2: MAX98357A; WLP-1.437mmx1.347mm-0.21mm-ball; MPN C2682619
U3: TP4054; SOT-23-5; MPN C668215
U4: ME6211C33M5G-N; SOT-23-5
U5: L; ICS43434_MEMS_Mic_Open; MPN C5656610
U6: ESP32-S3-MINI-1; MPN C3013941
U7: R; ICS43434_MEMS_Mic_Open; MPN C5656610

Connections:
+3V3: C1.1, C2.1, C3.1, C4.1, C6.2, C7.1, C8.1, C10.2, C11.1, C12.1, C13.1, C14.1, C15.1, C16.1, C17.1, C18.1, D4.2 (+), D5.2 (+), D6.2 (+), D7.2 (+), D8.2 (+), D9.2 (+), R2.1, U2.A2 (VDD), U4.5 (OUT), U5.5 (VDD), U6.3 (3V3), U7.2 (LR), U7.5 (VDD)
CHARGING: U3.1 (STAT), U6.17 (GPIO13)
D+: J3.4 (D+), J5.A6 (D+), J5.B6 (D+), U6.24 (GPIO20)
D-: J3.3 (D-), J5.A7 (D-), J5.B7 (D-), U6.23 (GPIO19)
GND: C1.2, C2.2, C3.2, C4.2, C5.2, C6.1, C7.2, C8.2, C9.2, C10.1, C11.2, C12.2, C13.2, C14.2, C15.2, C16.2, C17.2, C18.2, D1.1, D3.1, D4.3 (-), D5.3 (-), D6.3 (-), D7.3 (-), D8.3 (-), D9.3 (-), J1.1, J2.2, J3.5 (GND), J3.6 (GND), J5.A1 (GND), J5.A12 (GND), J5.B1 (GND), J5.B12 (GND), J5.S1 (SHIELD), R1.1, R3.2, R5.2, R6.1, SW2.1, U2.B2 (GAIN_SLOT), U2.C2 (GND), U3.2 (VSS), U4.2 (GND), U5.2 (LR), U5.3 (GND), U6.1 (GND), U6.2 (GND), U6.42 (GND), U6.43 (GND), U6.46 (GND), U6.47 (GND), U6.48 (GND), U6.49 (GND), U6.50 (GND), U6.51 (GND), U6.52 (GND), U6.53 (GND), U6.54 (GND), U6.55 (GND), U6.56 (GND), U6.57 (GND), U6.58 (GND), U6.59 (GND), U6.60 (GND), U6.61 (GND), U6.62 (GND), U6.63 (GND), U6.64 (GND), U6.65 (GND), U7.3 (GND)
MICSCK: U5.4 (SCK), U6.38 (GPIO42), U7.4 (SCK)
MICSD: U5.6 (SD), U6.37 (GPIO41), U7.6 (SD)
MICWS: U5.1 (WS), U6.36 (GPIO40), U7.1 (WS)
unnamed: D2.1 (K), Q1.2 (S), U4.1 (IN), U4.3 (EN)
unnamed: D4.4 (I), D9.1 (O)
unnamed: D4.1 (O), D5.4 (I)
unnamed: D5.1 (O), D8.4 (I)
unnamed: D6.4 (I), D8.1 (O)
unnamed: D6.1 (O), D7.4 (I)
unnamed: J1.2, U6.25 (GPIO21)
unnamed: J5.A5 (CC1), R5.1
unnamed: J5.B5 (CC2), R6.2
unnamed: LS1.2, U2.B3 (OUTN)
unnamed: LS1.1, U2.A3 (OUTP)
unnamed: R8.1, U2.A1 (~SD_MODE)
unnamed: R1.2, U3.5 (PROG)
unnamed: C9.1, R2.2, U6.45 (EN)
unnamed: R4.2, U6.19 (GPIO15)
PUSH: D3.2, SW2.2, U6.16 (GPIO12)
RGB: D9.4 (I), U6.5 (GPIO1)
SKPPWR: R8.2, U6.12 (GPIO8)
SKPSCK: U2.C1 (BCLK), U6.21 (GPIO17)
SKPSD: U2.B1 (DIN), U6.22 (GPIO18)
SKPWS: U2.C3 (LRCLK), U6.20 (GPIO16)
VBAT: D1.2, J2.1, Q1.3 (D), U3.3 (VBAT)
VBUS: C5.1, D2.2 (A), J3.1 (VBUS), J3.2 (VBUS), J5.A4 (VBUS), J5.A9 (VBUS), J5.B4 (VBUS), J5.B9 (VBUS), Q1.1 (G), R3.1, R4.1, U3.4 (VDD)

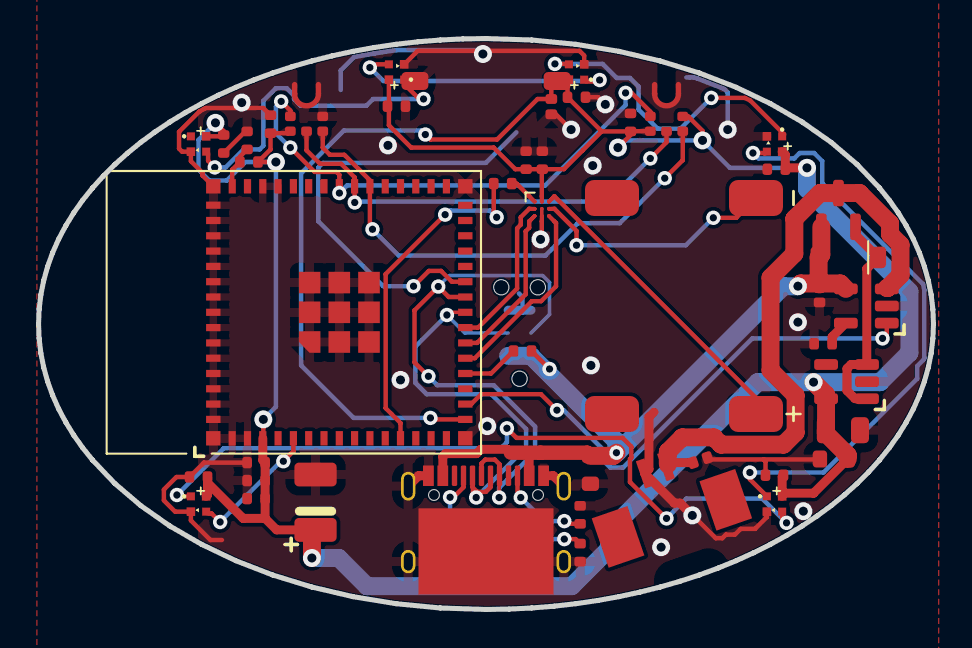
[picture p30: board CommBadge.kicad_pcb from above]

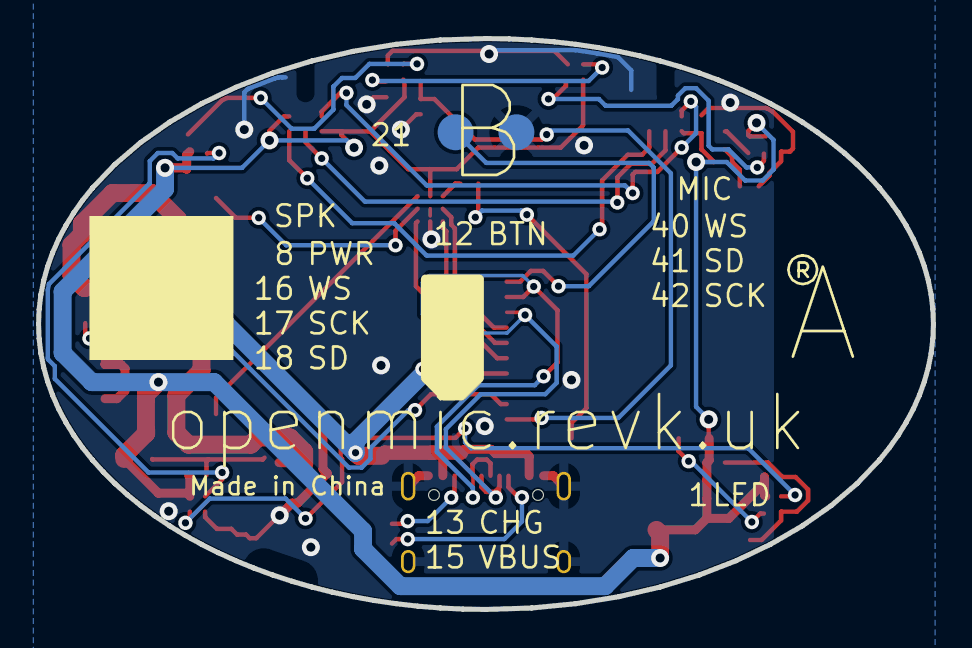
[picture p31: board CommBadge.kicad_pcb from below]

Board: 2 copper layers, 49.7 x 31.7 mm, 47 parts (2 on the bottom side), 31 nets.
