revk/OpenMic/(commit log)

2024-12-22 LED better
2024-12-22 No sleep if no button
2024-12-27 Tidy LED
2025-01-04 Started on STL (needs more work)
    [Recorder.kicad_pcb, Recorder.scad, Recorder.stl]
2025-01-04 Working on STL
    [Recorder.scad]
2025-01-04 Cleaner STL
    [Recorder.scad, Recorder.stl]
2025-01-04 Not sure it is right yet
    [Recorder.kicad_pcb, Recorder.scad, Recorder.stl]
2025-01-09 Nice HA button and status report
2025-01-13 Re render
    [Recorder.kicad_pcb]
2025-01-21 No point
    [Recorder.scad]
2025-01-22 Tweak SS
    [Recorder.kicad_pcb]
2025-01-22 Tidy readme
    [Recorder.kicad_pcb, Recorder.kicad_sch, bom.csv, positions.csv]
2025-01-22 Cleanup for latest kicad
    [Recorder.kicad_pcb, Recorder.kicad_sch, bom.csv, positions.csv]
2025-01-22 Fucking KiCAD changes
    [Recorder.kicad_pcb, Recorder.kicad_sch, bom.csv, positions.csv]
2025-01-23 PCB Update
    [CommBadge.kicad_pcb, CommBadge.kicad_sch, Intercom.kicad_pcb, Intercom.kicad_sch, OCS.kicad_pcb, OCS.kicad_sch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]
2025-02-07 Recorder GPIO and new PCBs
    [OCS.kicad_pcb, OCS.kicad_sch, bom.csv, designators.csv, positions.csv]
2025-02-13 Started new Intercom
    [Intercom.kicad_pcb, Intercom.kicad_sch, Recorder.kicad_sch]
2025-02-14 New PCB
    [Intercom.kicad_pcb, Intercom.kicad_sch, bom.csv, designators.csv, positions.csv]
2025-02-15 Tidy, new kicad
    [Intercom.kicad_pcb, Intercom.kicad_sch, bom.csv]
2025-02-15 Library update
    [Intercom.kicad_pcb]
2025-02-26 Larger text
    [Intercom.kicad_pcb]
2025-03-26 Power control for LEDs
    [Intercom.kicad_pcb, Intercom.kicad_sch, Recorder.kicad_pcb, Recorder.kicad_sch, Recorder.scad, Recorder.stl, bom.csv, designators.csv]
2025-03-26 Clean up
    [Recorder.kicad_pcb, Recorder.kicad_sch, bom.csv, positions.csv]
2025-04-02 LED power
2025-04-02 LED power, and update
2025-05-17 Tidy care render
    [Recorder.kicad_pcb, Recorder.scad, Recorder.stl]
2025-05-17 Blink when charging
2025-05-24 New battery case
    [Recorder.kicad_pcb, Recorder.kicad_sch, Recorder.stl, RecorderBat.scad, RecorderBat.stl, designators.csv, positions.csv]
2025-07-08 New layout
    [Recorder.kicad_pcb, Recorder.kicad_sch]
2025-07-09 Tracked for order
    [Recorder.kicad_pcb, Recorder.kicad_sch, bom.csv, designators.csv, positions.csv]
2025-07-26 Layout tweaks
    [Recorder.kicad_pcb, Recorder.kicad_sch, bom.csv, positions.csv]
2025-07-27 Moved GPIOs around a bit
    [Recorder.kicad_pcb, Recorder.kicad_sch, positions.csv]
2025-07-28 Recorder boards
2025-07-29 Battery level
2025-07-29 Download LEDs
2025-07-29 LEDs show beep status, and upgrade and upload
2025-07-29 Tidy non beep sync LEDs
2025-07-30 LED clean shutdown
2025-07-30 Fix button
2025-08-02 beep bug
    [Recorder.kicad_pcb, Recorder.kicad_sch]
2025-08-10 VBUS power to USB
2025-08-10 New renders
    [Recorder-2025-07-07-NoTag.stl, Recorder-2025-07-07.stl, Recorder.kicad_pcb, Recorder.scad, Recorder.stl, RecorderBat.stl, RecorderNoTag.scad, RecorderNoTag.stl]
2025-08-11 Re make
    [Recorder.scad, Recorder.stl, RecorderBat.scad, RecorderBat.stl, RecorderNoTag.scad, RecorderNoTag.stl]
2025-08-31 Case fix
    [Recorder.kicad_pcb, RecorderB.scad, RecorderB.stl, RecorderBatB.scad, RecorderBatB.stl, RecorderBatT.scad, RecorderBatT.stl, RecorderNoTagB.scad]
2025-08-31 Render as order
    [Recorder.kicad_pcb, Recorder.kicad_sch, RecorderB.scad, RecorderB.stl, RecorderBatB.scad, RecorderBatB.stl, RecorderBatT.scad, RecorderBatT.stl]
2025-09-01 Case render fix
    [Recorder.kicad_pcb, RecorderB.scad, RecorderB.stl, RecorderBatB.scad, RecorderBatB.stl, RecorderBatT.scad, RecorderBatT.stl, RecorderNoTagB.scad]
2025-09-01 More cases
    [RecorderB.scad, RecorderB.stl, RecorderBatB.scad, RecorderBatB.stl, RecorderBatNotTagB.scad, RecorderBatNotTagB.stl, RecorderBatNotTagT.scad, RecorderBatNotTagT.stl]
2025-09-02 Revised for order
    [Recorder.kicad_pcb, RecorderB.scad, RecorderB.stl, RecorderBatB.scad, RecorderBatB.stl, RecorderBatNotTagB.scad, RecorderBatNotTagB.stl, RecorderBatNotTagT.scad]
2025-09-08 needs work on case
    [Recorder.kicad_sch, RecorderB.scad, RecorderB.stl, RecorderBatB.scad, RecorderBatB.stl, RecorderBatNotTagB.scad, RecorderBatNotTagB.stl, RecorderBatNotTagT.scad]
2025-09-16 Clean up cases
    [RecorderB.scad, RecorderB.stl, RecorderBatB.scad, RecorderBatB.stl, RecorderBatNoTagB.scad, RecorderBatNoTagB.stl, RecorderBatNoTagT.scad, RecorderBatNoTagT.stl]
2025-09-16 Improved mic backing
    [RecorderB.scad, RecorderB.stl, RecorderBatB.scad, RecorderBatB.stl, RecorderBatNoTagB.scad, RecorderBatNoTagB.stl, RecorderBatNoTagT.scad, RecorderBatNoTagT.stl]
2025-09-16 More tidy
    [RecorderB.scad, RecorderB.stl, RecorderBatB.scad, RecorderBatB.stl, RecorderBatNoTagB.scad, RecorderBatNoTagB.stl, RecorderBatNoTagT.scad, RecorderBatNoTagT.stl]
2025-09-16 More tries
    [RecorderB.scad, RecorderB.stl, RecorderBatB.scad, RecorderBatB.stl, RecorderBatNoTagB.scad, RecorderBatNoTagB.stl, RecorderBatNoTagT.scad, RecorderBatNoTagT.stl]
2025-09-16 Small holes
    [RecorderB.scad, RecorderB.stl, RecorderBatB.scad, RecorderBatB.stl, RecorderBatNoTagB.scad, RecorderBatNoTagB.stl, RecorderBatNoTagT.scad, RecorderBatNoTagT.stl]
2025-09-17 Thicker base
    [RecorderB.scad, RecorderB.stl, RecorderBatB.scad, RecorderBatB.stl, RecorderBatNoTagB.scad, RecorderBatNoTagB.stl, RecorderBatNoTagT.scad, RecorderBatNoTagT.stl]
2025-09-17 USB plug tidy, ish
    [RecorderB.scad, RecorderB.stl, RecorderBatB.scad, RecorderBatB.stl, RecorderBatNoTagB.scad, RecorderBatNoTagB.stl, RecorderBatNoTagT.scad, RecorderBatNoTagT.stl]
2025-09-20 Better LED for hold to off, and better on/off logic
2025-10-10 New LEDs
    [Recorder.kicad_pcb, Recorder.kicad_sch, bom.csv, designators.csv, positions.csv]
2025-10-12 Thicker light pipes
    [RecorderB.scad, RecorderB.stl, RecorderBatB.scad, RecorderBatB.stl, RecorderBatNoTagB.scad, RecorderBatNoTagB.stl, RecorderBatNoTagT.scad, RecorderBatNoTagT.stl]
2025-10-25 micbeep causes cleaner red LED one second light
2025-10-25 Starting LED for beep cleaner
